Lafayette-FSAE/Carman-2021/CarMan KiCAD Schematics/Logic_2022/PiShield.jpg

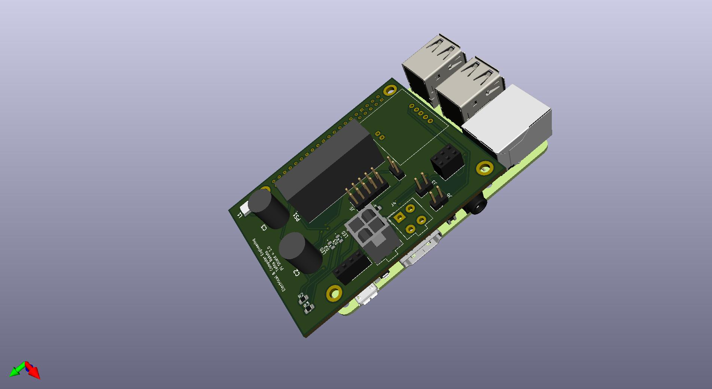
CarMan KiCAD Schematics/Logic_2022/PiShield.jpg
