Lafayette-FSAE/Carman-2021/CarMan KiCAD Schematics/Logic_2022/Logic_3D_Models/CUI_PYB20-Q24-S5-T.step

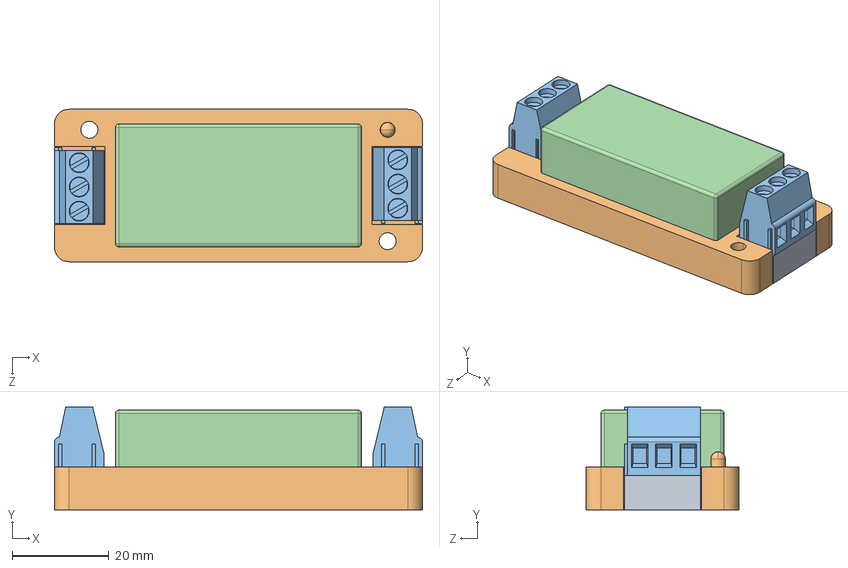
[picture p2: CAD file, 2021-02-16]
CarMan KiCAD Schematics/Logic_2022/Logic_3D_Models/CUI_PYB20-Q24-S5-T.step
76.0 x 21.2 x 31.5 mm
PYB1520-T cover
PYB1520-T case
DG128-5_DG128-5 (3) x 2
PYB20_PYB20-Q24-S5
