Lafayette-FSAE/Carman-2021/CarMan KiCAD Schematics/TSI/TSI_Rev.7/TSI_3D_Models/EHHD010A0B41-HZ--3DModel-STEP-56544.STEP

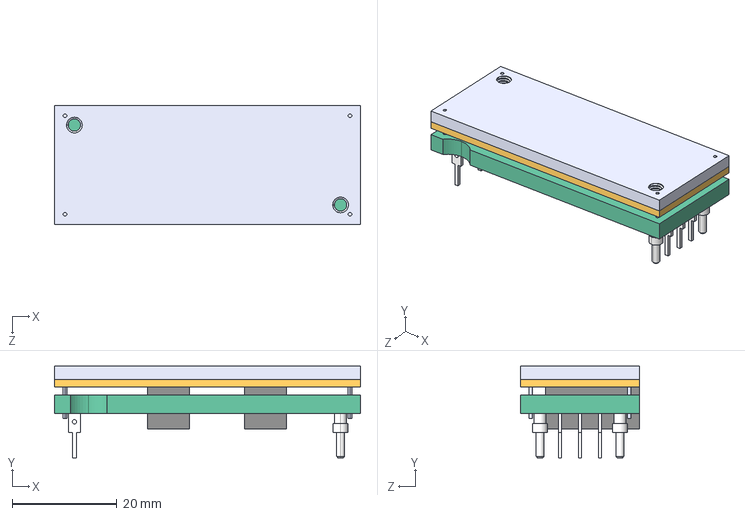
[picture p3: CAD file, 2021-02-16]
CarMan KiCAD Schematics/TSI/TSI_Rev.7/TSI_3D_Models/EHHD010A0B41-HZ--3DModel-STEP-56544.STEP
58.4 x 17.5 x 22.8 mm
