Lafayette-FSAE/Carman-2021/CarMan KiCAD Schematics/TSI/TSI_Rev.7/TSI_3D_Models/SFS2-DC24.step

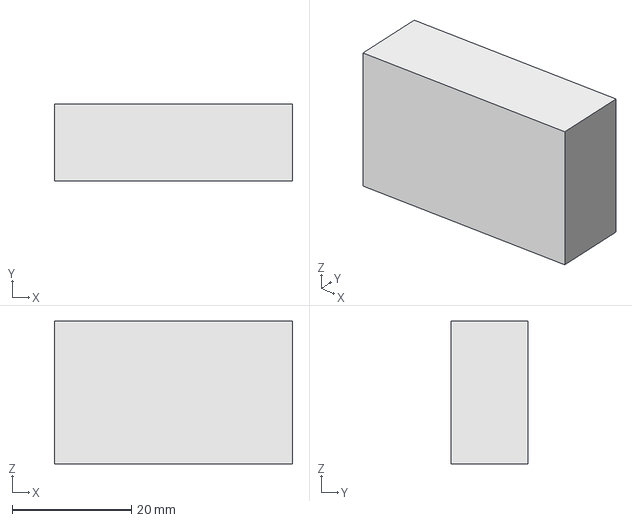
[picture p4: CAD file, 2021-02-16]
CarMan KiCAD Schematics/TSI/TSI_Rev.7/TSI_3D_Models/SFS2-DC24.step
40.0 x 13.0 x 24.0 mm
