Lafayette-FSAE/Carman-2021/CarMan KiCAD Schematics/Logic_2022/Logic_3D_Models/39281043.stp

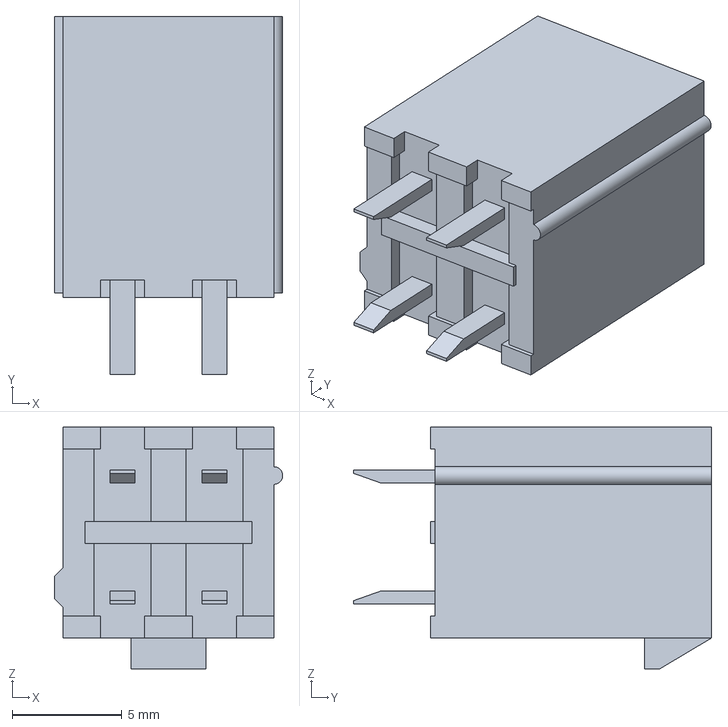
[picture p5: CAD file, 2021-02-16]
CarMan KiCAD Schematics/Logic_2022/Logic_3D_Models/39281043.stp
10.4 x 16.3 x 11.0 mm
