Lafayette-FSAE/Carman-2021/CarMan KiCAD Schematics/Logic_2022/Logic_3D_Models/39281023.stp

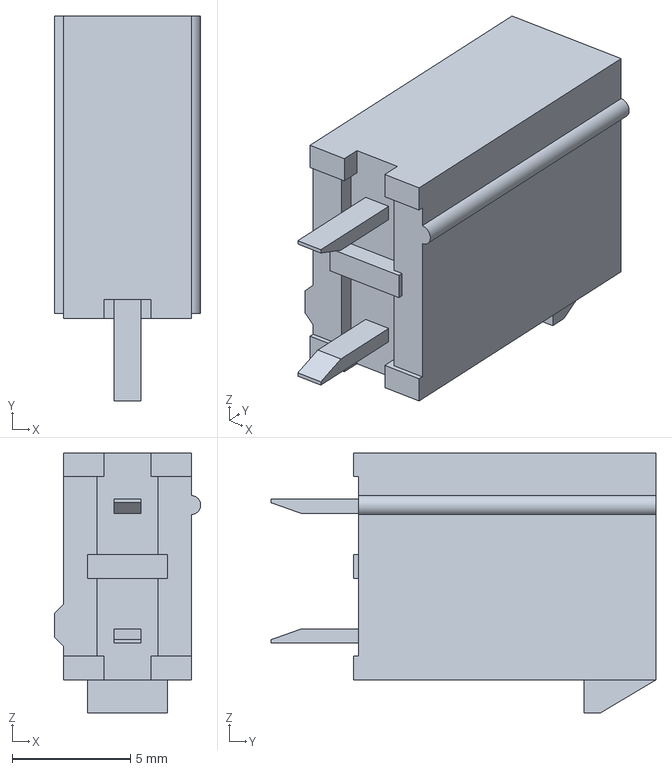
[picture p6: CAD file, 2021-02-16]
CarMan KiCAD Schematics/Logic_2022/Logic_3D_Models/39281023.stp
6.20 x 16.3 x 11.0 mm
