Lafayette-FSAE/Carman-2021/CarMan KiCAD Schematics/Logic_2022/Logic_3D_Models/39281063.stp

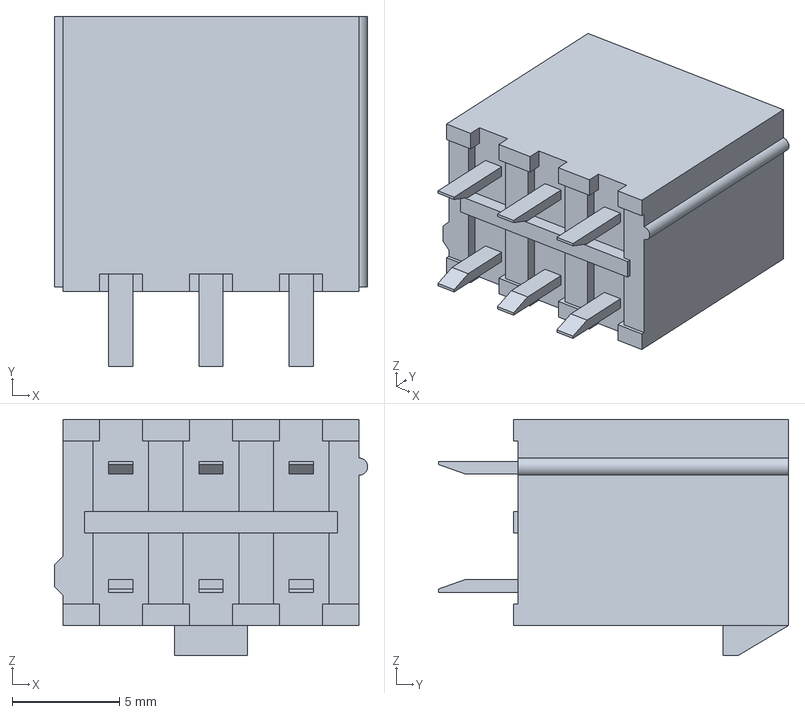
[picture p7: CAD file, 2021-02-16]
CarMan KiCAD Schematics/Logic_2022/Logic_3D_Models/39281063.stp
14.6 x 16.3 x 11.0 mm
