Lafayette-FSAE/Carman-2021/CarMan KiCAD Schematics/Logic_2022/PiShield.pdf

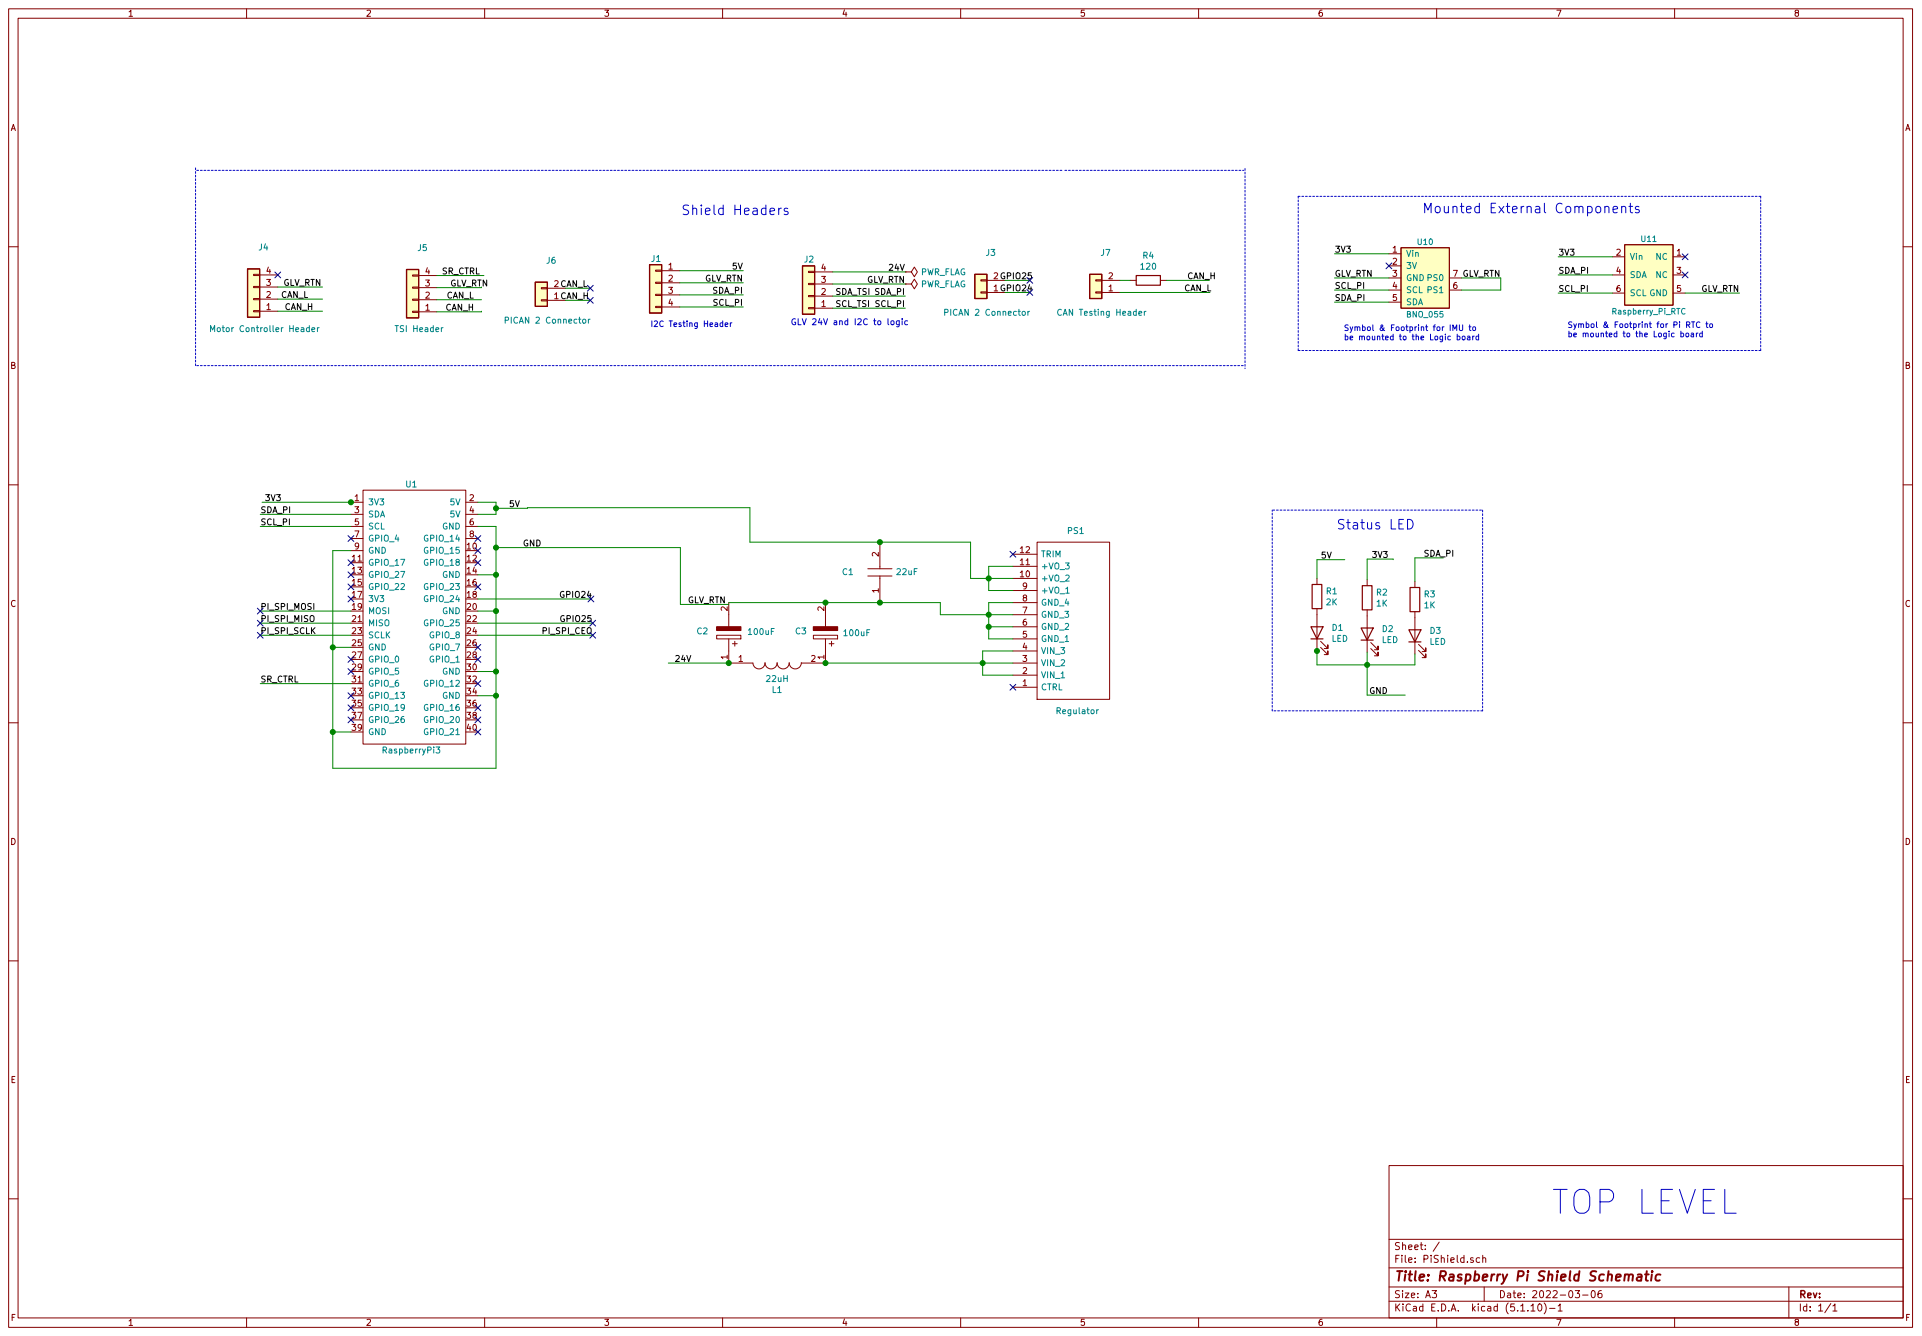
[picture p9: page 1]

be mounted to the Logic board Shield Headers

Symbol & Footprint for IMU to

Symbol & Footprint for Pi RTC to
be mounted to the Logic board

File: PiShield.sch Sheet: /
Id: 1/1 Title: Raspberry Pi Shield Schematic
