Lafayette-FSAE/Carman-2021/CarMan KiCAD Schematics/EPAL/EPAL.pdf

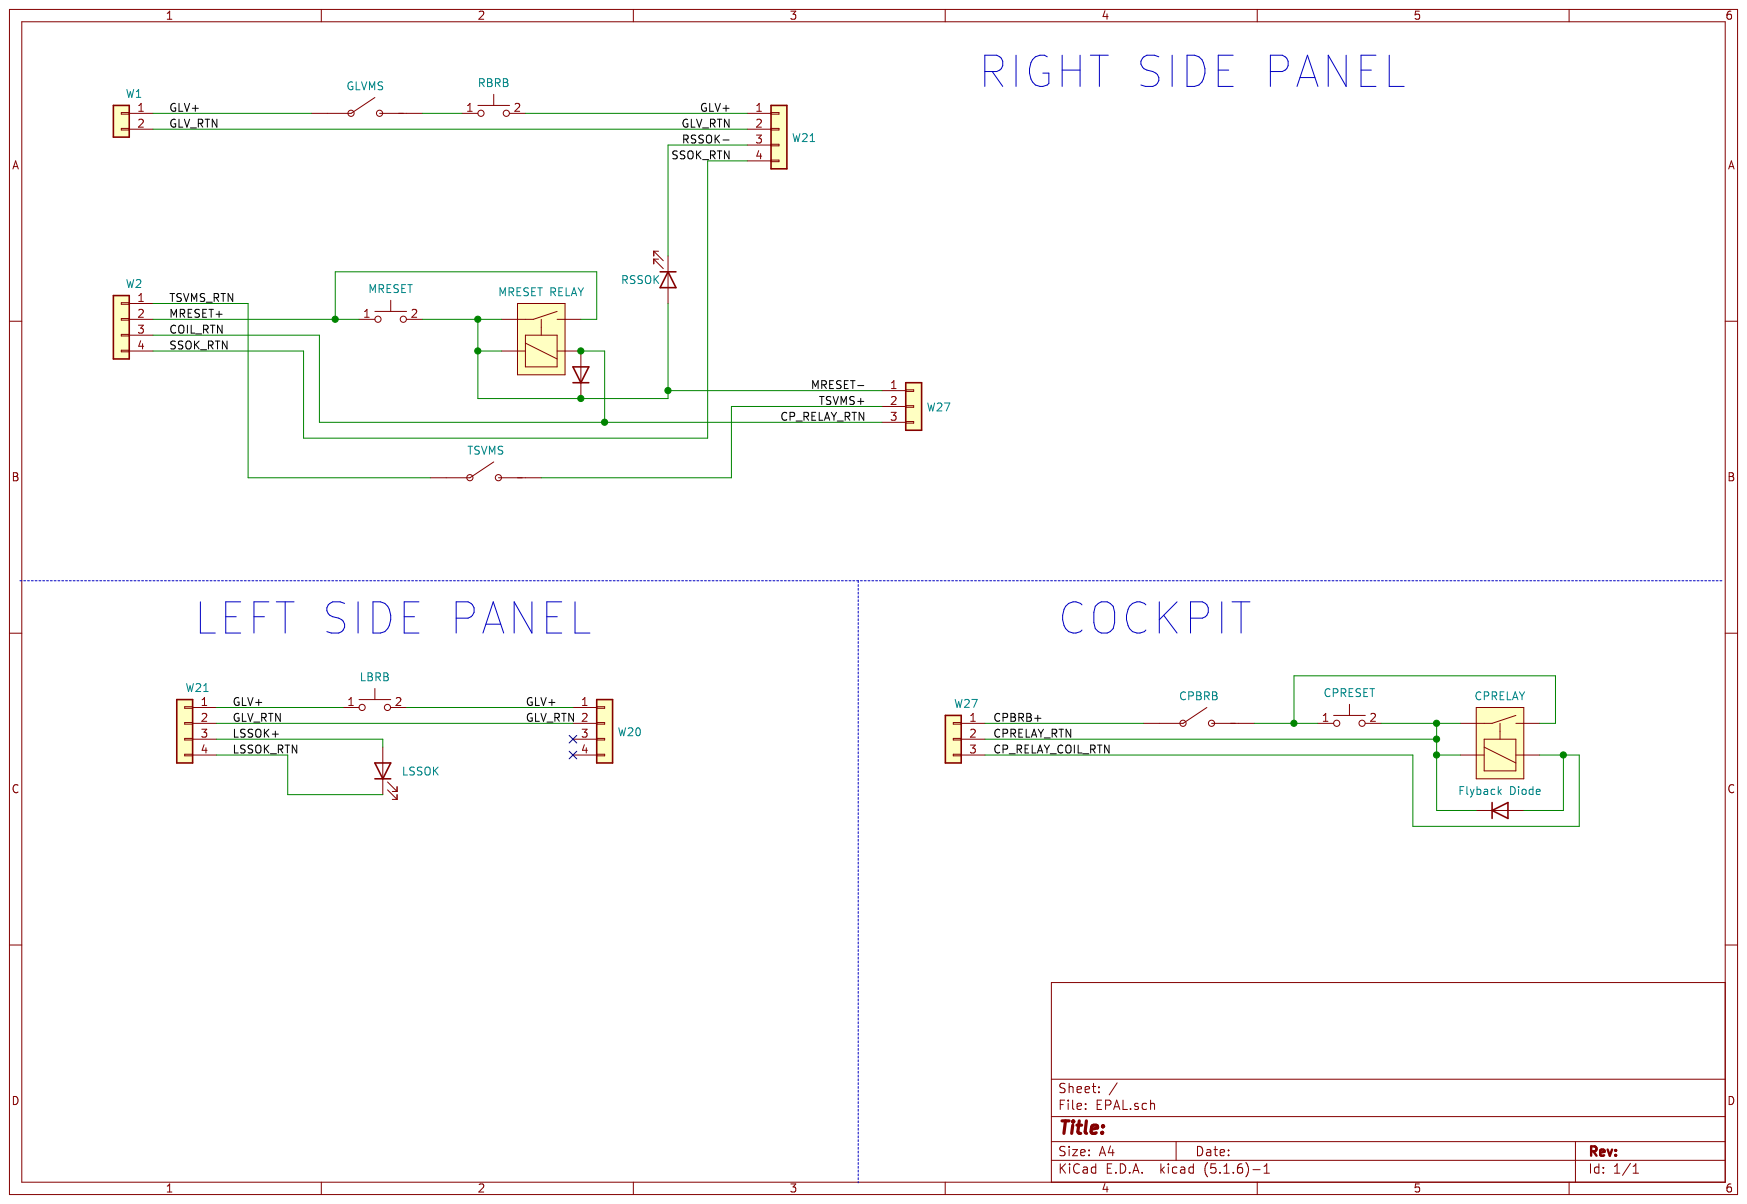
[picture p10: page 1]
