Lafayette-FSAE/Carman-2021/CarMan KiCAD Schematics/Logic_2022/PiShield.kicad_pcb

## KiCad design CarMan KiCAD Schematics/Logic_2022/PiShield.kicad_pcb (2022-04-07)

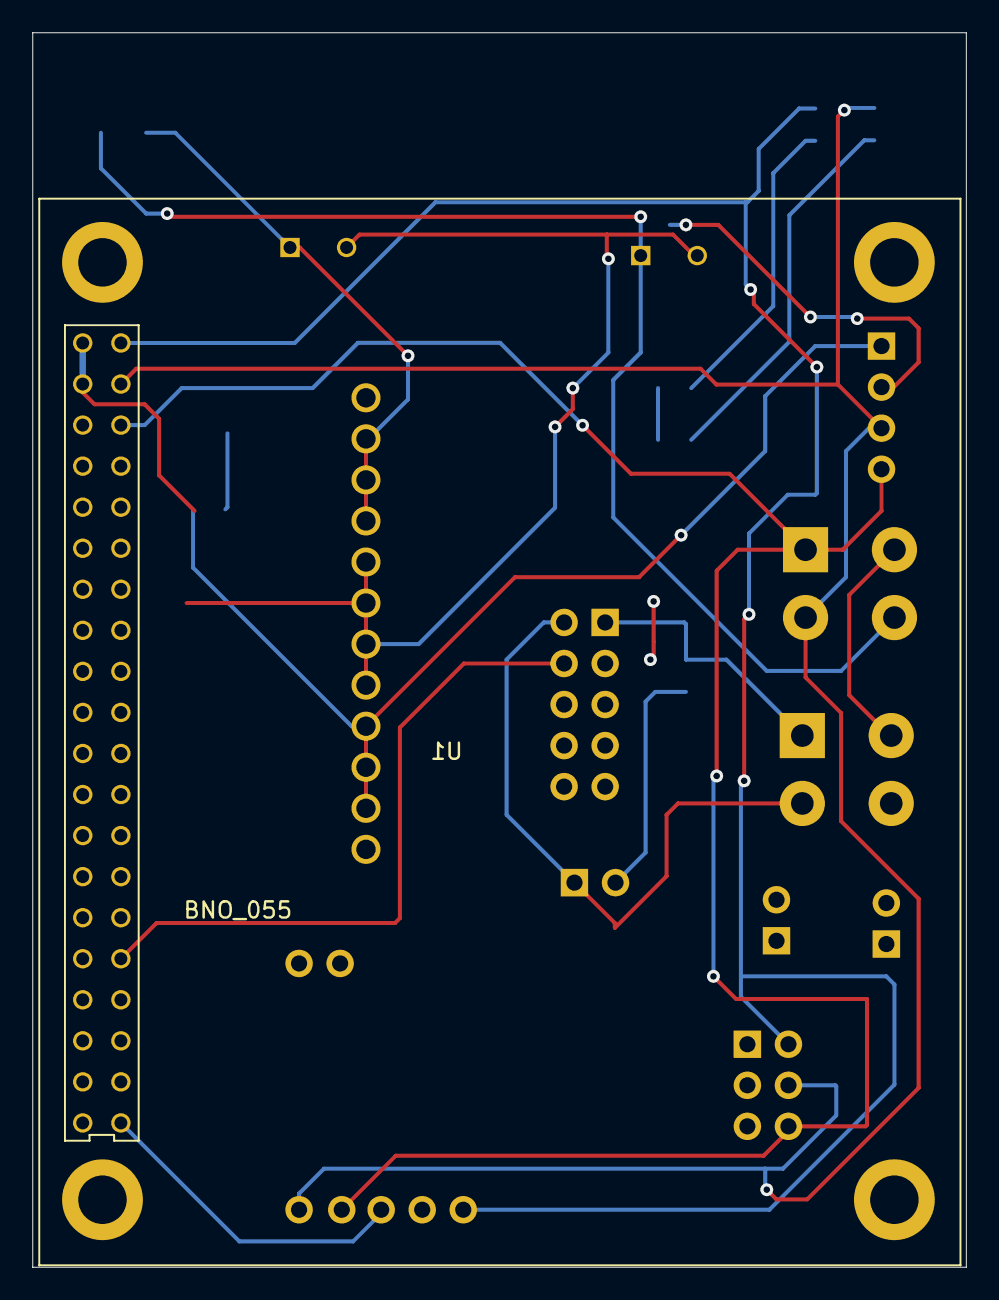
[picture p16: board PiShield.kicad_pcb from above]

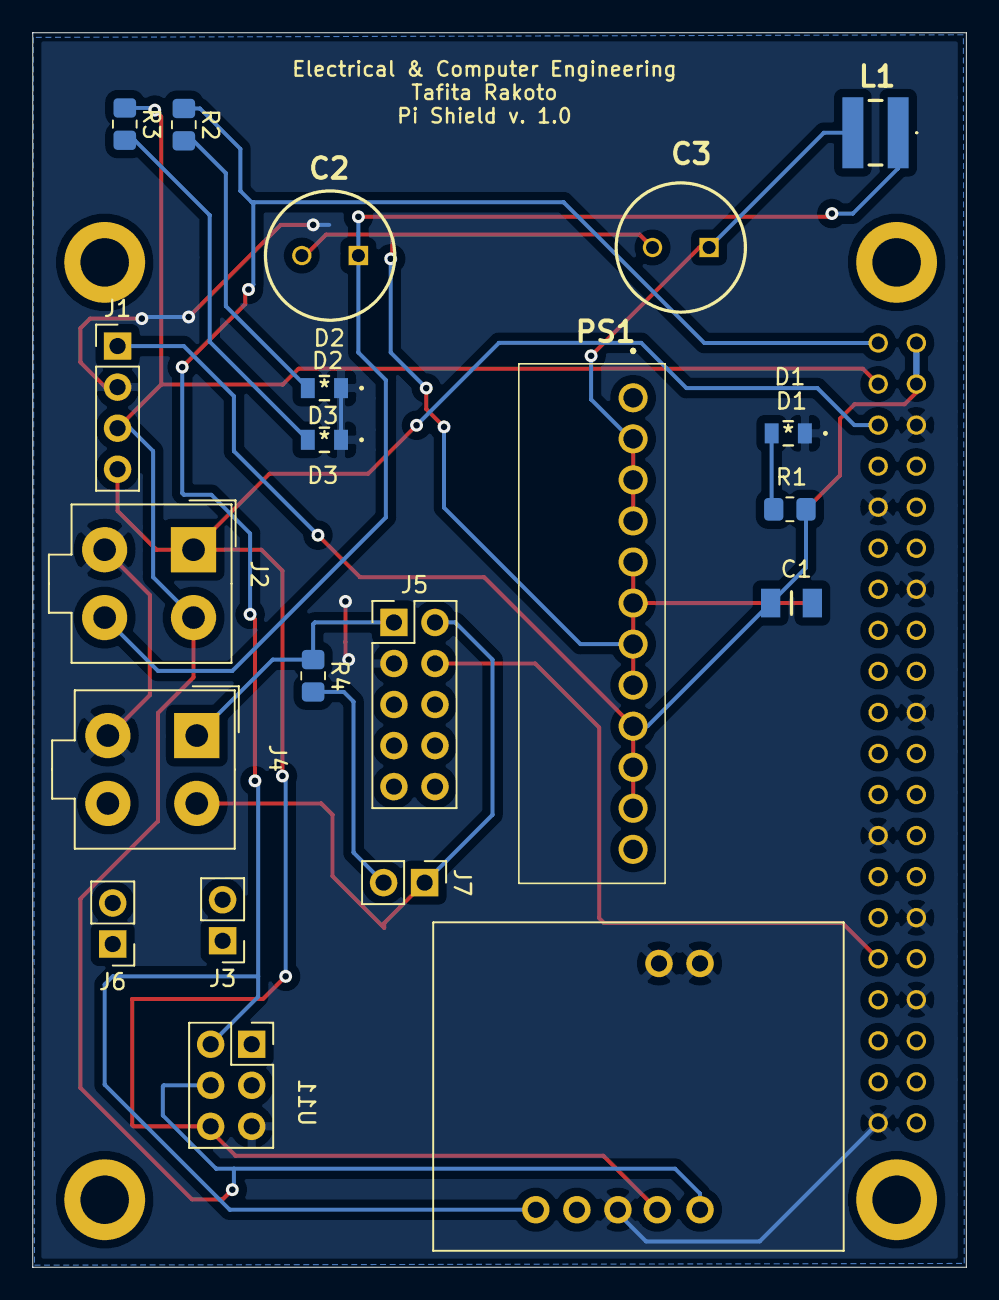
[picture p17: board PiShield.kicad_pcb from below]

Board: 2 copper layers, 57.8 x 76.4 mm, 22 parts (21 on the bottom side), 15 nets.

Parts:
C1: 22uF; CAPC3216X180N
C2, C3: 100uF; CAPPRD350W60D800H1250
D1: D1; VAOL-S8GT4
D2: D2; VAOL-S8GT4
D3: D3; VAOL-S8GT4
J1: I2C Testing Header; PinHeader_1x04_P2.54mm_Vertical
J2: J2; Molex_MiniFit-JR-5556-04A_2x02x4.20mm_Straight
J3: J3; PinHeader_1x02_P2.54mm_Vertical
J4: J4; Molex_MiniFit-JR-5556-04A_2x02x4.20mm_Straight
J5: J5; PinHeader_2x05_P2.54mm_Vertical
J6: J6; PinHeader_1x02_P2.54mm_Vertical
J7: J7; PinHeader_1x02_P2.54mm_Vertical
L1: 22uH; VLS4012HBX220MN
PS1: PS1; P783Q24S5S
R1: 2K; R_0805_2012Metric_Pad1.20x1.40mm_HandSolder
R2, R3: 1K; R_0805_2012Metric_Pad1.20x1.40mm_HandSolder
R4: 120; R_0805_2012Metric_Pad1.20x1.40mm_HandSolder
U1: RaspberryPi3; Raspberry_Pi_3_B
U10: BNO_055
U11: Raspberry_Pi_RTC

Connections:
/3V3: R2.1, U1.1, U10.1, U11.2
/5V: C1.2, J1.1, PS1.9, PS1.10, PS1.11, R1.1, U1.2, U1.4
/24V: C2.1, J2.4, L1.1
/CAN_H: J4.1, J5.1, R4.1
/CAN_L: J4.2, J5.2, J7.1
/GLV_RTN: D1.1, D2.1, D3.1, J1.2, J2.3, J4.3, J5.3, U1.6, U1.9, U1.14, U1.20, U1.25, U1.30, U1.34, U1.39, U10.3, U10.6, U10.7, U11.5
/SCL_PI: J1.4, J2.1, U1.5, U10.4, U11.6
/SDA_PI: J1.3, J2.2, R3.1, U1.3, U10.5, U11.4
/SR_CTRL: J5.4, U1.31
unnamed: C1.1, C2.2, C3.2, PS1.5, PS1.6, PS1.7, PS1.8
unnamed: C3.1, L1.2, PS1.2, PS1.3, PS1.4
unnamed: D1.2, R1.2
unnamed: D2.2, R2.2
unnamed: D3.2, R3.2
unnamed: J7.2, R4.2
