Lafayette-FSAE/Carman-2021/CarMan KiCAD Schematics/TSI/TSI_Rev.7/TSI_Rev.7.kicad_pcb

## KiCad design CarMan KiCAD Schematics/TSI/TSI_Rev.7/TSI_Rev.7.kicad_pcb (continued)

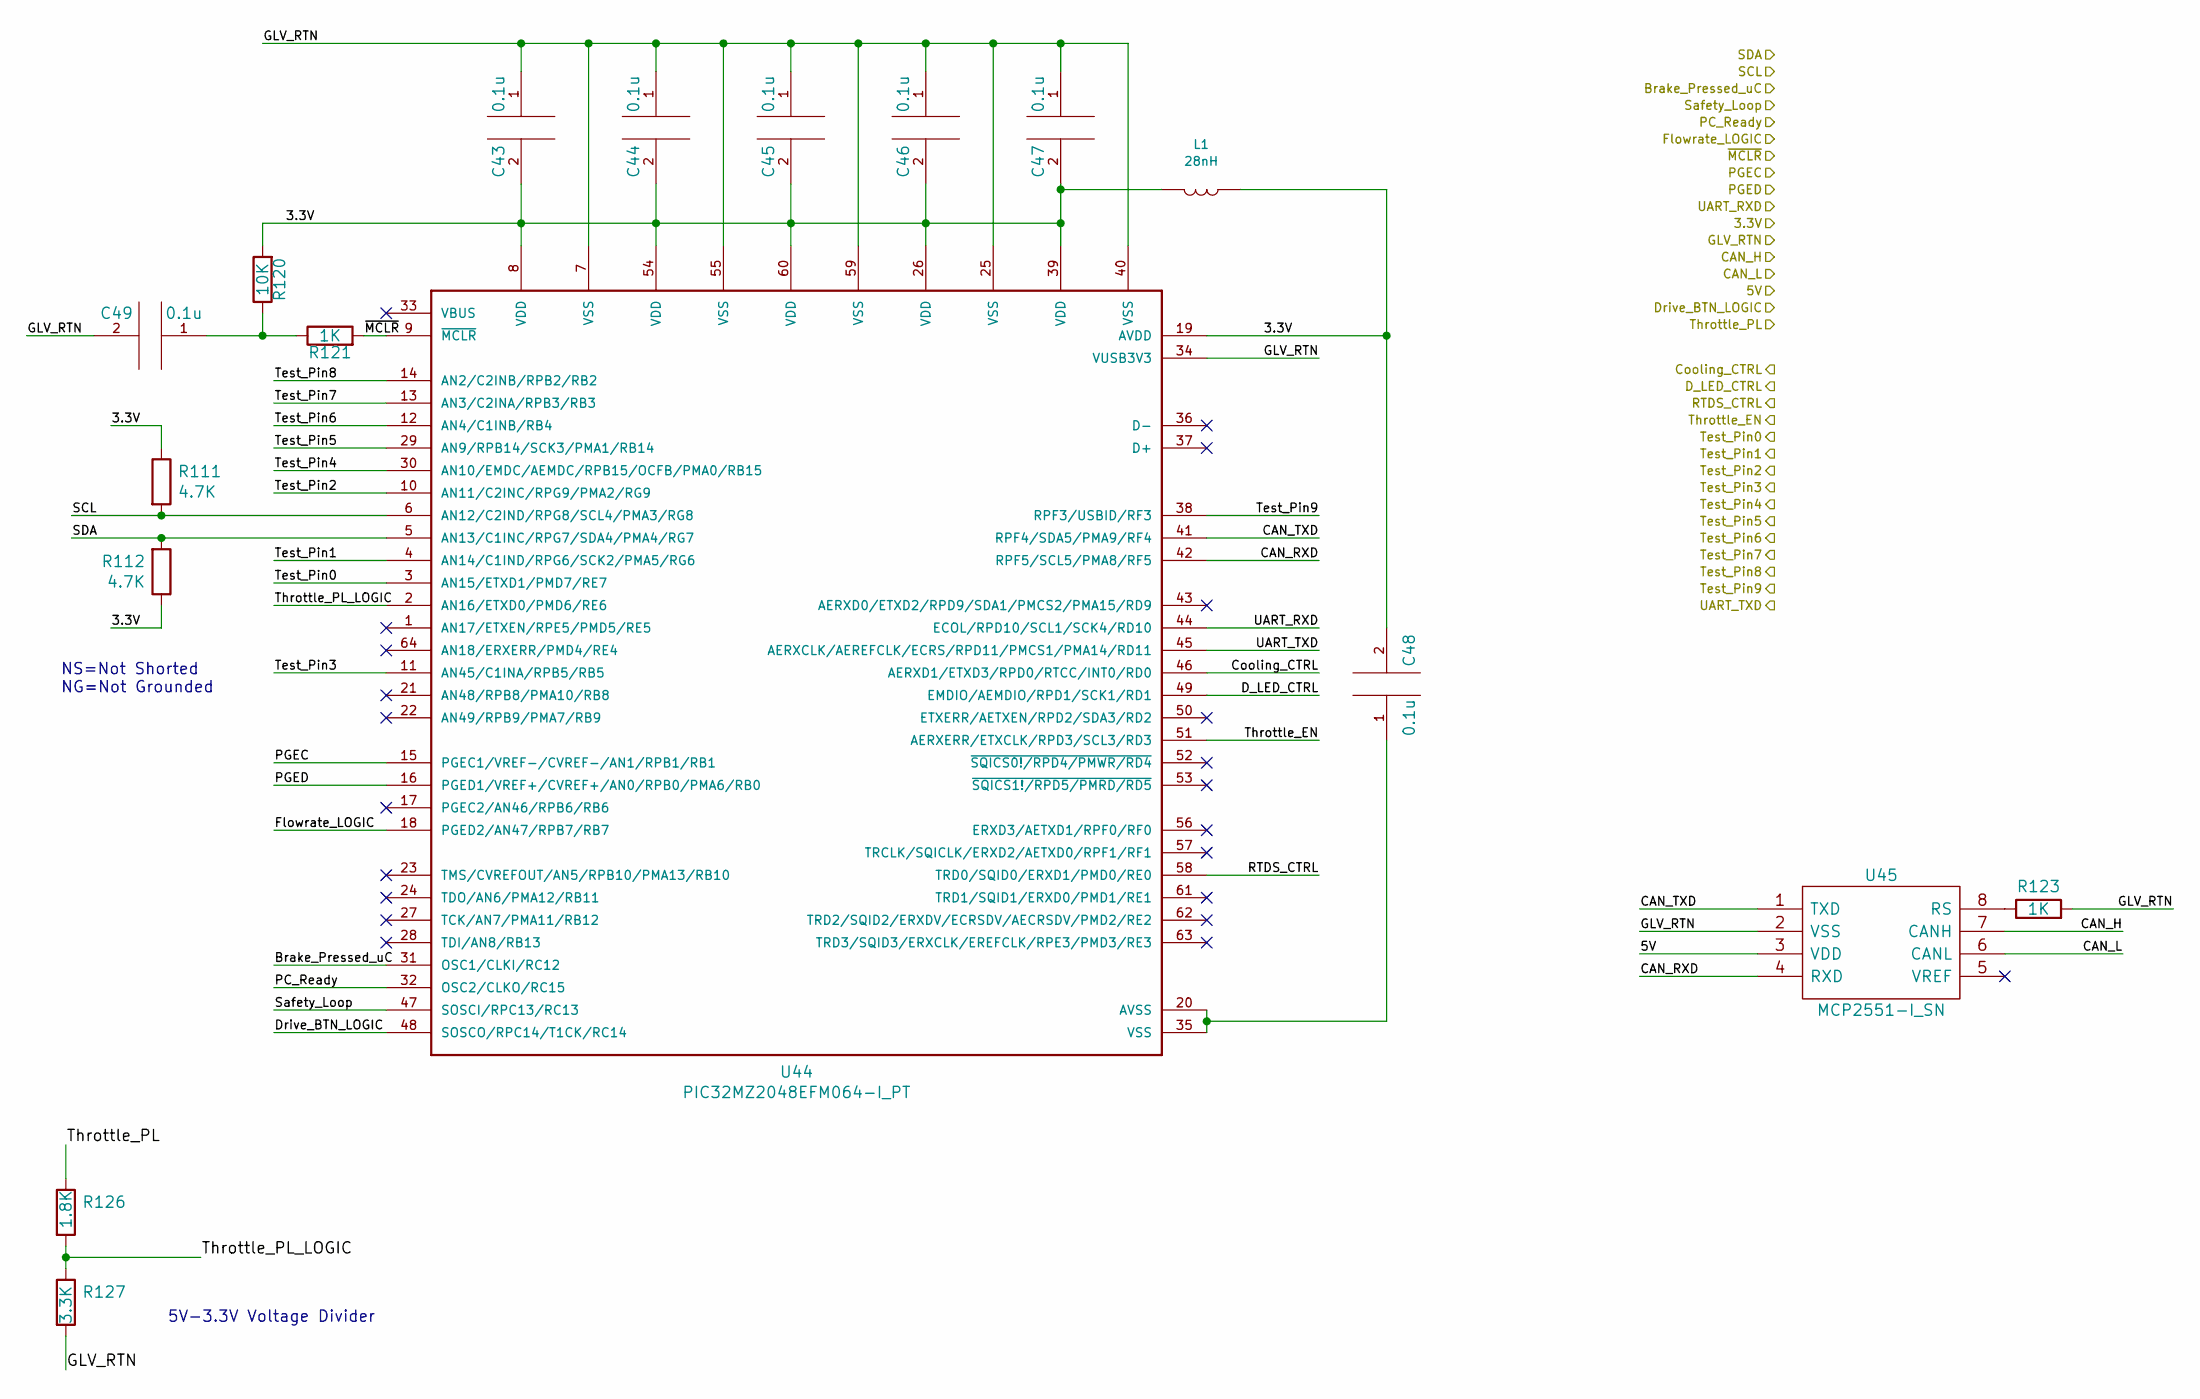
[picture p27: schematic PIC32.sch]

Parts:
C43, C44, C45, C46, C47, C48, C49: 0.1u; C_0805_2012Metric_Pad1.18x1.45mm_HandSolder
L1: 28nH; L_0805_2012Metric_Pad1.15x1.40mm_HandSolder
R111, R112: 4.7K; R_0805_2012Metric_Pad1.20x1.40mm_HandSolder
R120: 10K; R_0805_2012Metric_Pad1.20x1.40mm_HandSolder
R121, R123: 1K; R_0805_2012Metric_Pad1.20x1.40mm_HandSolder
R126: 1.8K; R_0805_2012Metric_Pad1.20x1.40mm_HandSolder
R127: 3.3K; R_0805_2012Metric_Pad1.20x1.40mm_HandSolder
U44: PIC32MZ2048EFM064-I_PT; QFP50P1200X1200X120-64N
U45: MCP2551-I_SN; SOIC127P600X175-8N; Manufacturer_Part_Number MCP2551-I/SN; Mouser Part Number 579-MCP2551-I/SN

Connections:
/3.3V: C43.2, C44.2, C45.2, C46.2, C47.2, C48.2, L1.1, L1.2, R111.1, R112.1, R120.2, U44.8 (VDD), U44.19 (AVDD), U44.26 (VDD), U44.39 (VDD), U44.54 (VDD), U44.60 (VDD); also elsewhere on the board
/5V: U45.3 (VDD); also elsewhere on the board
/AIRS-: C43.1, C44.1, C45.1, C46.1, C47.1, C49.2, R123.2, R127.2, U44.7 (VSS), U44.25 (VSS), U44.34 (VUSB3V3), U44.40 (VSS), U44.55 (VSS), U44.59 (VSS), U45.2 (VSS); also elsewhere on the board
/BP_CAN+: U45.7 (CANH); also elsewhere on the board
/BP_CAN-: U45.6 (CANL); also elsewhere on the board
/Brake_Pressed_uC: U44.31 (OSC1/CLKI/RC12); also elsewhere on the board
/Cooling_CTRL: U44.46 (AERXD1/ETXD3/RPD0/RTCC/INT0/RD0); also elsewhere on the board
/D_LED_CTRL: U44.49 (EMDIO/AEMDIO/RPD1/SCK1/RD1); also elsewhere on the board
/Drive_BTN_LOGIC: U44.48 (SOSCO/RPC14/T1CK/RC14); also elsewhere on the board
/Flowrate_LOGIC: U44.18 (PGED2/AN47/RPB7/RB7); also elsewhere on the board
/PC_Ready: U44.32 (OSC2/CLKO/RC15); also elsewhere on the board
/PGEC: U44.15 (PGEC1/VREF-/CVREF-/AN1/RPB1/RB1); also elsewhere on the board
/PGED: U44.16 (PGED1/VREF+/CVREF+/AN0/RPB0/PMA6/RB0); also elsewhere on the board
/PIC32/CAN_RXD: U44.42 (RPF5/SCL5/PMA8/RF5), U45.4 (RXD)
/PIC32/CAN_TXD: U44.41 (RPF4/SDA5/PMA9/RF4), U45.1 (TXD)
/PIC32/Throttle_PL_LOGIC: R126.2, R127.1, U44.2 (AN16/ETXD0/PMD6/RE6)
/RTDS_CTRL: U44.58 (TRD0/SQID0/ERXD1/PMD0/RE0); also elsewhere on the board
/SCL: R111.2, U44.6 (AN12/C2IND/RPG8/SCL4/PMA3/RG8); also elsewhere on the board
/SDA: R112.2, U44.5 (AN13/C1INC/RPG7/SDA4/PMA4/RG7); also elsewhere on the board
/Safety_Loop: U44.47 (SOSCI/RPC13/RC13); also elsewhere on the board
/Test_Pin0: U44.3 (AN15/ETXD1/PMD7/RE7); also elsewhere on the board
/Test_Pin1: U44.4 (AN14/C1IND/RPG6/SCK2/PMA5/RG6); also elsewhere on the board
/Test_Pin2: U44.10 (AN11/C2INC/RPG9/PMA2/RG9); also elsewhere on the board
/Test_Pin3: U44.11 (AN45/C1INA/RPB5/RB5); also elsewhere on the board
/Test_Pin4: U44.30 (AN10/EMDC/AEMDC/RPB15/OCFB/PMA0/RB15); also elsewhere on the board
/Test_Pin5: U44.29 (AN9/RPB14/SCK3/PMA1/RB14); also elsewhere on the board
/Test_Pin6: U44.12 (AN4/C1INB/RB4); also elsewhere on the board
/Test_Pin7: U44.13 (AN3/C2INA/RPB3/RB3); also elsewhere on the board
/Test_Pin8: U44.14 (AN2/C2INB/RPB2/RB2); also elsewhere on the board
/Test_Pin9: U44.38 (RPF3/USBID/RF3); also elsewhere on the board
/Throttle_EN: U44.51 (AERXERR/ETXCLK/RPD3/SCL3/RD3); also elsewhere on the board
/Throttle_PL: R126.1; also elsewhere on the board
/UART_RXD: U44.44 (ECOL/RPD10/SCL1/SCK4/RD10); also elsewhere on the board
/UART_TXD: U44.45 (AERXCLK/AEREFCLK/ECRS/RPD11/PMCS1/PMA14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); also elsewhere on the board
/~MCLR: R121.2, U44.9 (~MCLR~); also elsewhere on the board
unnamed: C48.1, U44.20 (AVSS), U44.35 (VSS)
unnamed: C49.1, R120.1, R121.1
unnamed: R123.1, U45.8 (RS)

Notes on the sheet:
NS=Not Shorted NG=Not Grounded
5V-3.3V Voltage Divider

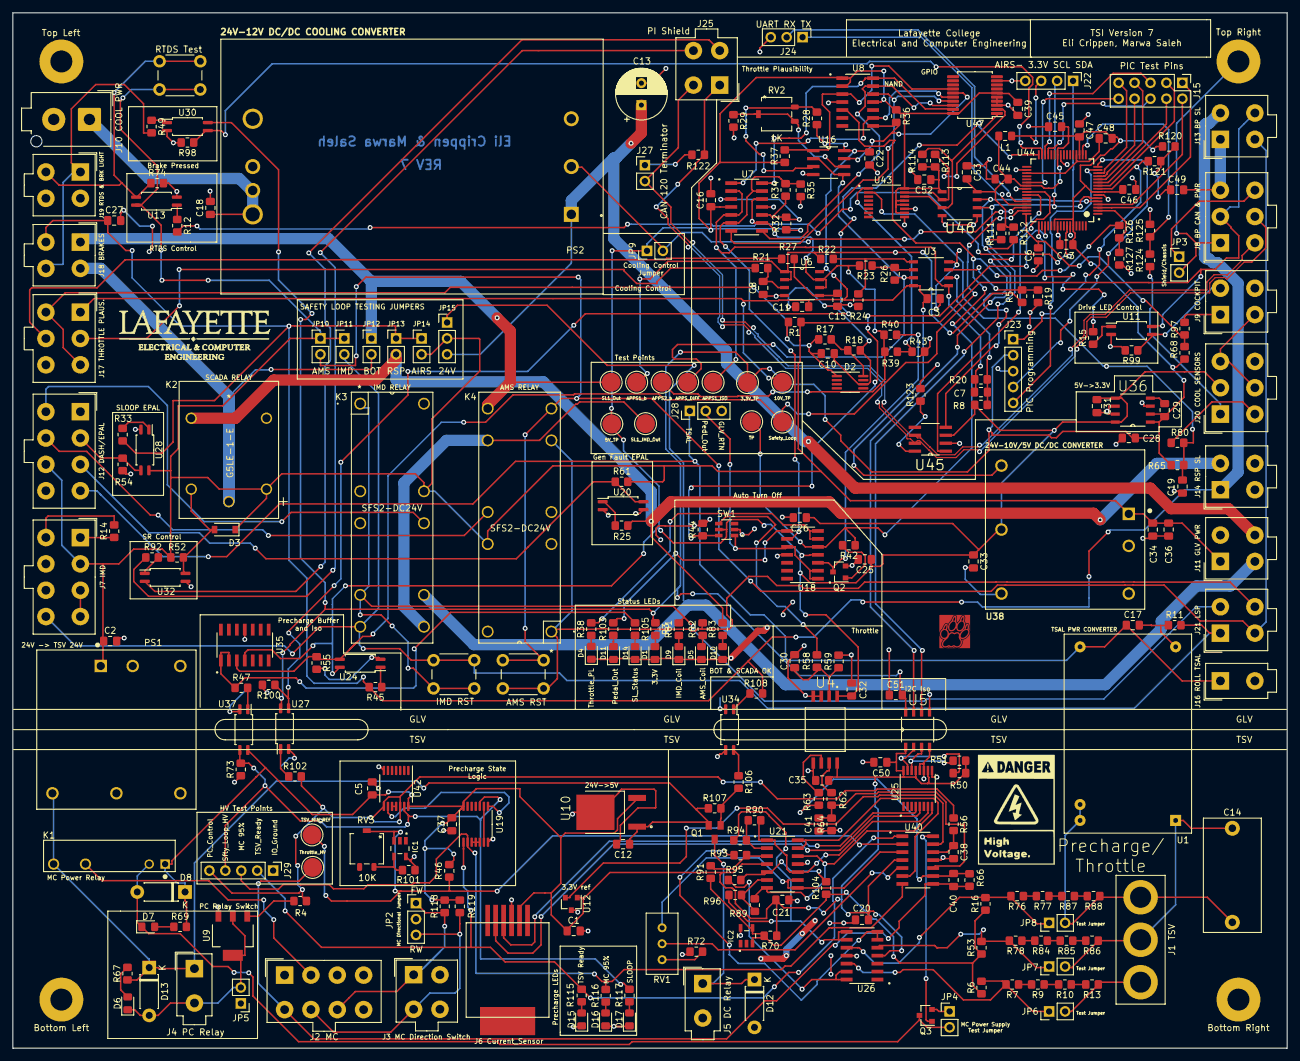
[picture p28: board TSI_Rev.7.kicad_pcb from above]

Board: 2 copper layers, 203.2 x 165.1 mm, 295 parts (0 on the bottom side), 192 nets.

Other parts of the board:
VAL: REF; lafLogo
