Lafayette-FSAE/Carman-2021/CarMan KiCAD Schematics/GLV_BOBV6/GLV_BOBV6.kicad_pcb

## KiCad design CarMan KiCAD Schematics/GLV_BOBV6/GLV_BOBV6.kicad_pcb (2021-04-27)

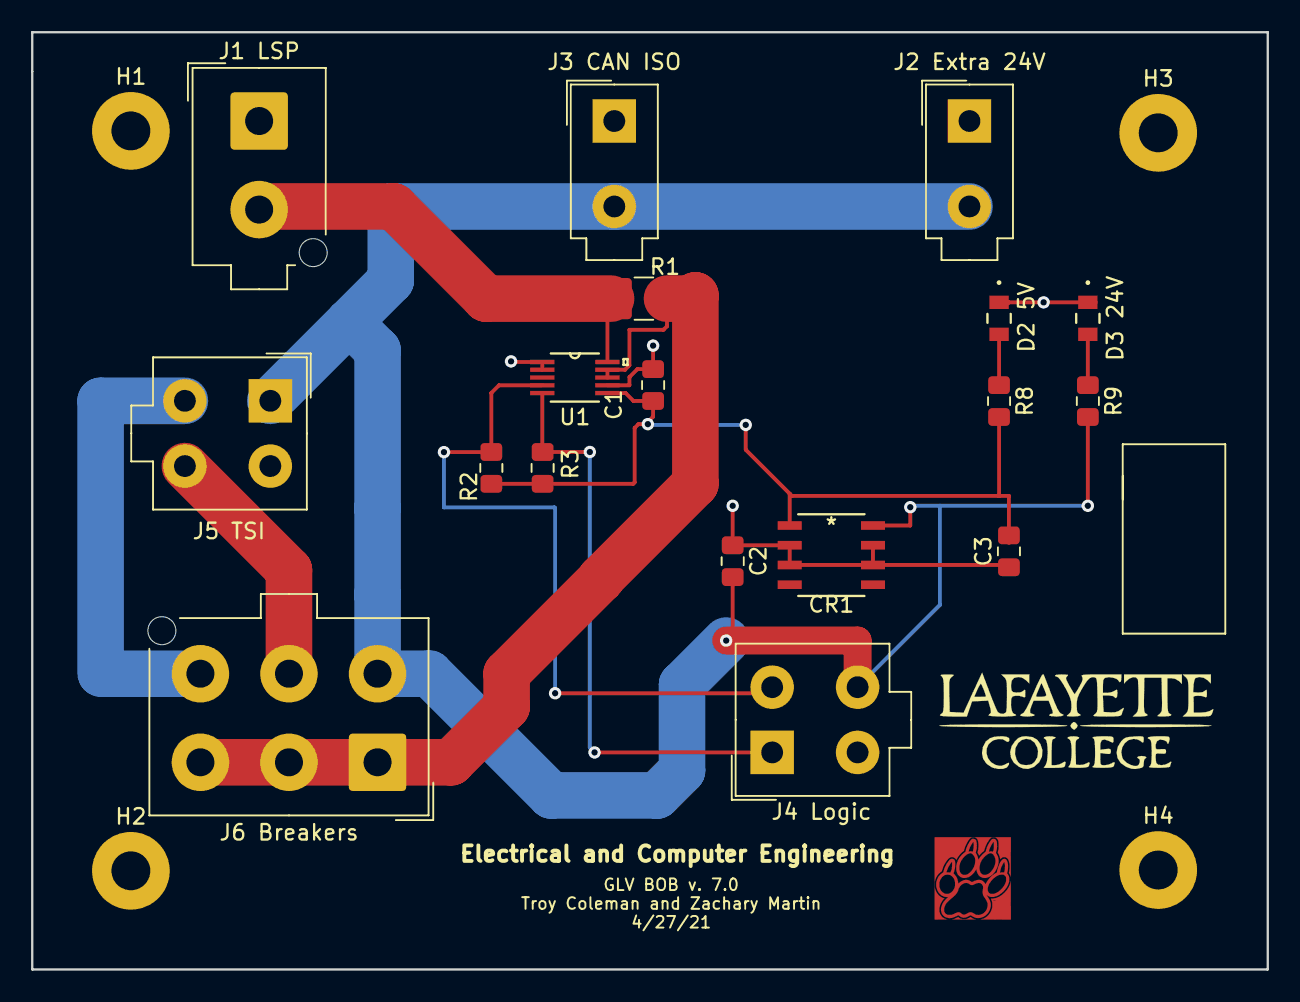
[picture p29: board GLV_BOBV6.kicad_pcb from above]

Board: 2 copper layers, 79.5 x 60.3 mm, 23 parts (0 on the bottom side), 11 nets.

Parts:
C1, C3: 0.1uF; C_0805_2012Metric_Pad1.15x1.40mm_HandSolder
C2: 0.33uF; C_0805_2012Metric_Pad1.15x1.40mm_HandSolder
CR1: L78L05ACD13TR
D2 5V, D3 24V: LED; VAOL-S8GT4
H1, H2, H3, H4: MountingHole; MountingHole_2.5mm_Pad
J1 LSP: Conn_01x02; Molex_Mega-Fit_76829-0102_2x01_P5.70mm_Vertical
J2 Extra 24V, J3 CAN ISO: Conn_01x02; Molex_MiniFit-JR-5556-02A_2x01x4.20mm_Straight
J4 Logic, J5 TSI: Conn_02x02_Odd_Even; Molex_MiniFit-JR-5556-04A_2x02x4.20mm_Straight
J6 Breakers: J6; Molex_Mega-Fit_76829-0106_2x03_P5.70mm_Vertical
R1: 0.001; R_1210_3225Metric_Pad1.42x2.65mm_HandSolder
R2, R3, R8, R9: 10K; R_0805_2012Metric_Pad1.15x1.40mm_HandSolder
U1: INA226AIDGSR
VAL: REF; lafLogo

Connections:
/5V_NON_ISO: C1.1, C3.2, CR1.1, R2.1, R3.1, R8.2, U1.6
/24V: C2.2, CR1.8, J2 Extra 24V.2, J3 CAN ISO.2, J4 Logic.4, J5 TSI.1, J6 Breakers.4, R9.2
/24V_NOT_BREAKERED: J6 Breakers.1, J6 Breakers.2, J6 Breakers.3, R1.1, U1.8, U1.9
/BATT+: J1 LSP.2, R1.2, U1.10
/BREAKER_OUT_COOL: J5 TSI.4, J6 Breakers.5
/BREAKER_OUT_SL: J5 TSI.3, J6 Breakers.6
/GLV_RTN: C1.2, C2.1, C3.1, CR1.2, CR1.3, CR1.6, CR1.7, D2 5V.1, D3 24V.1, J1 LSP.1, J2 Extra 24V.1, J3 CAN ISO.1, J4 Logic.3, J5 TSI.2, U1.1, U1.2, U1.7
/SCL_NOT_ISO: J4 Logic.1, R3.2, U1.5
/SDA_NOT_ISO: J4 Logic.2, R2.2, U1.4
unnamed: D2 5V.2, R8.1
unnamed: D3 24V.2, R9.1
