Lafayette-FSAE/Carman-2021/(commit log)

2020-10-20 Added Folders for each board
2020-10-25 8 Pin Addition
2020-10-25 New Upload
    [TSI_Rev.5.kicad_pcb, TSI_Rev.5.sch]
2020-10-25 Top-Level TSI
    [TSI_Rev.5.sch]
2020-10-25 Updated Libraries and created logic board
    [Logic.kicad_pcb, Logic.sch, PIC32.sch, SCADA.sch]
2020-10-25 Added GLV Schematic
    [GLV_BOBV6.kicad_pcb, GLV_BOBV6.sch]
2020-10-25 TSI KiCAD- TP
    [TSI_Rev.5.sch]
2020-10-26 Lib Update, TSi Update
    [TSI_Rev.5.sch]
2020-10-26 GLV with VA Sensor and I2C ISO
    [sensorGLV.sch]
2020-10-26 TSI-TP Update
    [TSI_Rev.5.sch, TSI_Throttle_Plausibility.sch]
2020-10-27 TSI update
    [TSI_Rev.5.sch, TSI_Throttle_Plausibility.sch]
2020-10-27 GLV Schematic/Library Update
    [GLV_BOBV6.sch]
2020-10-27 GLV Schematic Fix - Logic Power
    [GLV_BOBV6.sch, sensorGLV.sch]
2020-10-27 Finished Logic Board schematic and removed old schematics
    [Logic.sch, PIC32.sch, PiHat.sch, SCADA.sch]
2020-10-27 GLV Comment
    [GLV_BOBV6.sch]
2020-10-27 u dumb
    [TSI_Throttle_Plausibility.sch]
2020-10-27 Update, error fix
    [PCDC_Circuit.sch, TSI_Rev.5.sch, TSI_Throttle_Plausibility.sch]
2020-10-27 Refactored repo
    [Logic.kicad_pcb, Logic.sch, PiHat.sch]
2020-10-27 GLV Tentatively Finished
    [GLV_BOBV6.sch, sensorGLV.sch]
2020-10-27 GLV Tentatively Finished with part labels
    [GLV_BOBV6.sch]
2020-10-27 Sensors & Throttle Iso
    [PCDC_Circuit.sch, Sensors-Throttle.sch, TSI_Rev.5.sch, TSI_Throttle_Plausibility.sch]
2020-10-27 Sensors &Throttle ISO 2
2020-10-27 Finished temp/current sensor and TV ISO
    [Sensors-Throttle.sch, TSI_Rev.5.sch]
2020-10-27 Update Lib
    [CAN_GLV_POWER.sch, PCDC_Circuit.sch, Sensors-Throttle.sch, StatusLights_Cockpit.sch, TSI_Rev.5.sch, TSI_Throttle_Plausibility.sch]
2020-10-28 GLV with Cooling Connector
    [GLV_BOBV6.sch]
2020-10-28 Update lib, TSAL & CAN/GLV
    [CAN_GLV_POWER.sch, PCDC_Circuit.sch, Sensors-Throttle.sch, StatusLights_Cockpit.sch, TSI_Rev.5.sch, TSI_Throttle_Plausibility.sch]
2020-10-28 TSI Fixes - Hi Neal
    [CAN_GLV_POWER.sch, PCDC_Circuit.sch, Sensors-Throttle.sch, StatusLights_Cockpit.sch, TSI_Rev.5.sch, TSI_Throttle_Plausibility.sch]
2020-10-28 Updated Logic to run off of 5V not 24V
    [Logic.sch, TSI-Cooling.sch, TSI_Rev.5.kicad_pcb]
2020-10-29 Fixed More TSI connections/renamed things
    [CAN_GLV_POWER.sch, PCDC_Circuit.sch, Sensors-Throttle.sch, StatusLights_Cockpit.sch, TSI_Rev.5.sch, TSI_Throttle_Plausibility.sch]
2020-10-29 TSI - Added 24V- 5v isolated converter, Scada relay, and fixed connections
    [CAN_GLV_POWER.sch, Logic_Power_And_CAN_Isolators.sch, PCDC_Circuit.sch, Sensors-Throttle.sch, StatusLights_Cockpit.sch, TSI_Rev.5.sch, TSI_Throttle_Plausibility.sch]
2020-10-29 Res/Cap Value Updates & Organizational
    [CAN_GLV_POWER.sch, PCDC_Circuit.sch, Sensors-Throttle.sch, StatusLights_Cockpit.sch, TSI_Rev.5.sch, TSI_Throttle_Plausibility.sch]
2020-10-30 Added Cooling isolator and fault logic sheet
    [CAN_GLV_POWER.sch, Fault_Logic_And_Timing_Circuit.sch, PCDC_Circuit.sch, Sensors-Throttle.sch, StatusLights_Cockpit.sch, TSI_Rev.5.sch, TSI_Throttle_Plausibility.sch]
2020-10-30 Added isolation to CANBUS
    [Logic.sch, PiHat.sch]
2020-10-30 Actually isolated things this time
    [Logic.sch]
2020-10-30 Pls help
    [CAN_GLV_POWER.sch, Logic_Power_And_CAN_Isolators.sch, PCDC_Circuit.sch, Sensors-Throttle.sch, StatusLights_Cockpit.sch, TSI_Rev.5.sch, TSI_Throttle_Plausibility.sch]
2020-10-31 Added convertor for IMD_Status, fixed IMD/AMS led logic and Reset RC timing.
    [Fault_Logic_And_Timing_Circuit.sch]
2020-11-01 Segmented TSI connectors to be HV and LV, Removed redundant IMD LED logic.
    [CAN_GLV_POWER.sch, StatusLights_Cockpit.sch, TSI_Rev.5.sch]
2020-11-01 Updated GLV with breaker connectors and connections, changed I2C PU resistors, added remaining pwr flags.
    [GLV_BOBV6.sch, sensorGLV.sch]
2020-11-02 Fixed Logic library issue, added I2C translator to Logic, matched I2C names for TSI-Logic
    [Logic.sch, PiHat.sch, TSI_Rev.5.sch]
2020-11-03 TSI J13 & TSI J14
    [TSI_Rev.5.sch]
2020-11-03 NO J12
    [TSI_Rev.5.sch]
2020-11-03 J16 - Added added SL1_In
    [TSI_Rev.5.sch]
2020-11-03 Removed CAN Transciever from CAN & GLV Power, edited net listing on PCDC Circuit regarding Safety_Loop Iso and extraneous connector
    [Fault_Logic_And_Timing_Circuit.sch, Logic_Power_And_CAN_Isolators.sch, PCDC_Circuit.sch, Sensors-Throttle.sch, StatusLights_Cockpit.sch, TSI_Rev.5.sch, TSI_Throttle_Plausibility.sch]
2020-11-03 BP_HV - > Brake_Pressed_HV net list changes
    [CAN_GLV_POWER.sch, PCDC_Circuit.sch, TSI_Rev.5.sch]
2020-11-10 TSI Re-labeling
    [TSI_Rev.5.sch]
2020-11-10 Fixed Logic Board
    [Logic.sch, PiHat.sch]
2020-11-10 changed logic isolation
    [Logic.sch, LogicPower.sch, PiHat.sch]
2020-11-11 GLV with updated connector names, removed isolated converter and I2C isolator
    [GLV_BOBV6.sch]
2020-11-11 Added EPAL schematics and SLOOP
    [EPAL.kicad_pcb, EPAL.sch, SLOOP.kicad_pcb, SLOOP.sch]
2020-11-14 TSI with Cooling + Scada Relay, new Cooling Connector
    [CAN_GLV_POWER.sch, StatusLights_Cockpit.sch, TSI_Rev.5.sch]
2020-11-16 updated Epal and Sloop
    [SLOOP.sch]
2020-11-16 Added 24v to connection between GLV and Logic and updated headers accordingly
    [GLV_BOBV6.sch, Logic.sch, LogicPower.sch, PiHat.sch]
2020-11-16 Updated Pi GPIO and connector between Logic and TSI
    [CAN_GLV_POWER.sch, Logic.sch, PCDC_Circuit.sch, Sensors-Throttle.sch, StatusLights_Cockpit.sch, TSI_Rev.5.sch, TSI_Throttle_Plausibility.sch]
2020-11-16 updated Sloop once more
    [SLOOP.sch]
2020-11-17 Footprint Work
    [CAN_GLV_POWER.sch, Fault_Logic_And_Timing_Circuit.sch, PCDC_Circuit.sch, Sensors-Throttle.sch, StatusLights_Cockpit.sch, TSI_Rev.5.sch, TSI_Throttle_Plausibility.sch]
2020-11-17 Footprint Work II
2020-11-17 TSI: Added 24 to 12V converter, V dividers for IMD_Status, Throttle_PL, corrected pins 1-5 TSI-Logic Logic:24 to 5V non iso conv, safety_loop isolated, fixed I2C
    [CAN_GLV_POWER.sch, Logic.sch, LogicPower.sch, PiHat.sch, StatusLights_Cockpit.sch, TSI_Rev.5.sch, TSI_Throttle_Plausibility.sch]
2020-11-17 fixed some bullshit
    [CAN_GLV_POWER.sch, Fault_Logic_And_Timing_Circuit.sch, Logic.sch, PCDC_Circuit.sch, Sensors-Throttle.sch, StatusLights_Cockpit.sch, TSI_Rev.5.sch, TSI_Throttle_Plausibility.sch]
2020-11-17 - Fixed General Throttle Plausibility Nonsense - Added footprint and individual part for TS372
    [TSI_Throttle_Plausibility.sch]
2020-11-18 Sloop Latching Logique
    [SLOOP.sch]
2020-11-18 Added BOT brake light breaking
    [SLOOP.sch]
2020-11-18 Aesthetics, IMD Relay
    [CAN_GLV_POWER.sch, PCDC_Circuit.sch, Sensors-Throttle.sch, StatusLights_Cockpit.sch, TSI_Rev.5.sch, TSI_Throttle_Plausibility.sch]
2020-11-18 - removed Sloop Enable 1 & 2 from J6 - Wired J16 correctly
    [CAN_GLV_POWER.sch, TSI_Rev.5.sch, TSI_Throttle_Plausibility.sch]
2020-11-19 TSI Foot printing
    [PCDC_Circuit.sch, Sensors-Throttle.sch, TSI_Rev.5.sch, TSI_Throttle_Plausibility.sch]
2020-11-19 Carman Footprint Library, GLV PCB v1
    [GLV_BOBV6.sch]
2020-11-20 Fixed some broken connections/errors on TSI
    [CAN_GLV_POWER.sch, PCDC_Circuit.sch, Sensors-Throttle.sch, StatusLights_Cockpit.sch, TSI_Rev.5.sch]
2020-11-20 Logic Footprints in General Library, Added Logic LEDs
    [Logic.sch, LogicPower.sch, PiHat.sch]
2020-11-20 GLV PCB redone to be cleaner
    [GLV_BOBV6.kicad_pcb]
2020-11-22 GLV PCB edge cuts, logos, increased BATT+ trace widths, Gerber files
    [GLV_BOBV6-B_Cu.gbr, GLV_BOBV6-B_Mask.gbr, GLV_BOBV6-B_Paste.gbr, GLV_BOBV6-B_SilkS.gbr, GLV_BOBV6-Edge_Cuts.gbr, GLV_BOBV6-F_Cu.gbr, GLV_BOBV6-F_Mask.gbr, GLV_BOBV6-F_Paste.gbr]
2020-11-22 Added AIRS monitor signal to Pi, added all Logic Footprints
    [Logic.sch, PiHat.sch]
2020-11-23 Logic PCB started, Pi 3B footprint fixed
    [Logic.sch, LogicPower.sch, PiHat.sch]
2020-11-23 footprinting, datasheeting, general bug fixes * Added TSAL & TSAL Cockpit labels
    [CAN_GLV_POWER.sch, PCDC_Circuit.sch, Sensors-Throttle.sch, StatusLights_Cockpit.sch, TSI_Rev.5.sch]
2020-11-23 - TSAL_RTN connected to GLV_RTN
    [TSI_Rev.5.sch]
2020-11-24 Logic PCB updates, Fixed I2C and ground connections in Logic
    [GLV_BOBV6.kicad_pcb, Logic.kicad_pcb, Logic.sch]
2020-11-24 - TSI editing, Xsistor selection, footprints
    [CAN_GLV_POWER.sch, PCDC_Circuit.sch, StatusLights_Cockpit.sch, TSI_Rev.5.sch]
2020-11-25 Updated latching logic
    [SLOOP.sch, SLOOP_test.sch]
2020-11-26 updated Sloop once again
    [SLOOP.sch, SLOOP_test.sch]
2020-11-26 Safety Loops Edits to TSI
    [CAN_GLV_POWER.sch, Sensors-Throttle.sch, TSI_Rev.5.sch]
2020-11-27 - Aesthetics - TSI Safety Loop Edits - Battery pack connection editing
    [CAN_GLV_POWER.sch, StatusLights_Cockpit.sch, TSI_Rev.5.sch]
2020-11-27 - Aesthetics Part II
    [TSI_Rev.5.sch]
2020-11-27 Too big Logic PCB finished
    [Logic.kicad_pcb]
2021-01-11 GLV removed 24V to dash and 24V to BP headers. Logic almost done pending, design review
    [GLV_BOBV6-B_Cu.gbr, GLV_BOBV6-B_Mask.gbr, GLV_BOBV6-B_Paste.gbr, GLV_BOBV6-B_SilkS.gbr, GLV_BOBV6-Edge_Cuts.gbr, GLV_BOBV6-F_Cu.gbr, GLV_BOBV6-F_Mask.gbr, GLV_BOBV6-F_Paste.gbr]
2021-01-12 Smol Edits
    [CAN_GLV_POWER.sch, PCDC_Circuit.sch, Sensors-Throttle.sch]
2021-01-12 Added footprints for MCP6004
    [PCDC_Circuit.sch, Sensors-Throttle.sch, TSI_Rev.5.sch, TSI_Throttle_Plausibility.sch]
2021-01-12 Added Footprints for TS 912
    [TSI_Throttle_Plausibility.sch]
2021-01-12 TSI Footprints - Res, Caps, Inductor all 0805s - Mounting Holes
    [CAN_GLV_POWER.sch, PCDC_Circuit.sch, Sensors-Throttle.sch, StatusLights_Cockpit.sch, TSI_Rev.5.sch, TSI_Throttle_Plausibility.sch]
2021-01-12 TSI Footprints
2021-01-13 TSI Footprinting (~80%) - Added Molex - Added Current Sensor
    [CAN_GLV_POWER.sch, PCDC_Circuit.sch, Sensors-Throttle.sch, StatusLights_Cockpit.sch, TSI_Rev.5.sch, TSI_Throttle_Plausibility.sch]
2021-01-13 TSI Footprinting (~90%)
    [CAN_GLV_POWER.sch, PCDC_Circuit.sch, StatusLights_Cockpit.sch, TSI_Rev.5.sch, TSI_Throttle_Plausibility.sch]
2021-01-13 Bug Fixins
    [CAN_GLV_POWER.sch, PCDC_Circuit.sch, StatusLights_Cockpit.sch, TSI_Rev.5.sch]
2021-01-13 TSI Footprinting (~95%) - Added Silk Screen Images from last years projects (not added to any libraries, just folder)
    [CAN_GLV_POWER.sch, PCDC_Circuit.sch, StatusLights_Cockpit.sch, TSI_Throttle_Plausibility.sch]
2021-01-13 TSI Footprinting (~98%) - Assigned U41 footprint to PS1 footprint. Not able to find PS1 footprint. Referenced last years design and took measurement on PCB. Measured as the same distances between poi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
    [CAN_GLV_POWER.sch, PCDC_Circuit.sch, StatusLights_Cockpit.sch, TSI_Rev.5.sch, TSI_Throttle_Plausibility.sch]
2021-01-13 TSI Footprinting (~99%) - Need footprint for J1
    [CAN_GLV_POWER.sch]
2021-01-13 Small edits
    [TSI_Rev.5.sch]
2021-01-13 TSI Footprinting (100%) - Created symbol for connector J1
    [TSI_Rev.5.sch]
2021-01-14 Started TSI PCB
    [CAN_GLV_POWER.sch, PCDC_Circuit.sch, Sensors-Throttle.sch, TSI_Rev.5.kicad_pcb, TSI_Rev.5.sch]
2021-01-14 - Updated logic header footprints on TSI
    [TSI_Rev.5.kicad_pcb, TSI_Rev.5.sch]
2021-01-14 Started TSI layout
    [PCDC_Circuit.sch, TSI_Rev.5.kicad_pcb, TSI_Rev.5.sch]
2021-01-14 TSI High Voltage placed
    [TSI_Rev.5.kicad_pcb]
2021-01-14 Organized LV into groupings
    [CAN_GLV_POWER.sch, PCDC_Circuit.sch, TSI_Rev.5.kicad_pcb, TSI_Throttle_Plausibility.sch]
2021-01-14 Organizational Added jumper between chassis ground and can shield
    [TSI_Rev.5.kicad_pcb, TSI_Rev.5.sch]
2021-01-14 more TSI work
    [TSI_Rev.5.kicad_pcb]
2021-01-15 Low Voltage (Throttle Plausibility)
    [PCDC_Circuit.sch, TSI_Rev.5.kicad_pcb]
2021-01-15 HV Finished
    [TSI_Rev.5.kicad_pcb]
2021-01-15 LV Edited
    [TSI_Rev.5.kicad_pcb]
2021-01-16 TSI Layout (~65%)
    [TSI_Rev.5.kicad_pcb]
2021-01-16 TTSI Layout (~93%)
    [TSI_Rev.5.kicad_pcb]
2021-01-16 TSI (~95%) - Verify Safety Loop signal - Remove Testing connector/change signals - Place Test pads - Aesthetic tweaks
    [PCDC_Circuit.sch, TSI_Rev.5.kicad_pcb]
2021-01-16 TSI (~97%)
    [CAN_GLV_POWER.sch, PCDC_Circuit.sch, Sensors-Throttle.sch, TSI_Rev.5.kicad_pcb, TSI_Rev.5.sch, TSI_Throttle_Plausibility.sch]
2021-01-16 TSI (~98%) - Added right side testing connector - Finish left side testing connector - Added Caps to HV side
    [TSI_Rev.5.kicad_pcb, TSI_Rev.5.sch]
2021-01-17 TSI (~98.5%)
    [CAN_GLV_POWER.sch, PCDC_Circuit.sch, StatusLights_Cockpit.sch, TSI_Rev.5.kicad_pcb, TSI_Rev.5.sch, TSI_Throttle_Plausibility.sch]
2021-01-18 TSI (~99%) - Confirmed TSI pin headers and logic pin header alignment - Divided board into several sections - Placed TSV testing pads and made last connection
    [CAN_GLV_POWER.sch, Logic.kicad_pcb, TSI_Rev.5.kicad_pcb]
2021-01-18 Updated board, added silk art
    [Sensors-Throttle.sch, TSI_Rev.5.kicad_pcb, TSI_Rev.5.sch, TSI_Throttle_Plausibility.sch]
2021-01-18 Updated component links
    [TSI_Throttle_Plausibility.sch]
2021-01-18 Updated Components
    [PCDC_Circuit.sch]
2021-01-19 C13 Footprint
    [CAN_GLV_POWER.sch, TSI_Rev.5.sch]
2021-01-19 Changed RV4 and RV5 footprint
    [PCDC_Circuit.sch, TSI_Throttle_Plausibility.sch]
2021-01-19 TSI (99.5%) - Updated footprints on pcb
    [TSI_Rev.5.kicad_pcb]
2021-01-19 TSI Signal Review ISSUES: - PCDC 'Pre_Charge_Ready' and 'PC_Ready' discrepancy - TSI Rev.4 IC1, IC4 -> PCDC & Isolators
    REMOVED SIGNALS:
    Throttle Plausibility
    - PC_Ready
    - Drive_BTN
    PCDC
    - HV+
    - HV-
    - Throttle_HV
    - IGNI_GND
    STATUS LIGHTS & COCKPIT
    - BP
    - BP_RTN
    - IMD_Status
    - 5V
    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
    [PCDC_Circuit.sch, Sensors-Throttle.sch, StatusLights_Cockpit.sch, TSI_Rev.5.sch, TSI_Throttle_Plausibility.sch]
2021-01-20 Updated Signals and Trace Width
    [CAN_GLV_POWER.sch, Sensors-Throttle.sch, TSI_Rev.5.kicad_pcb, TSI_Rev.5.sch, TSI_Throttle_Plausibility.sch]
2021-01-20 Updated trace width and connector naming
    [TSI_Rev.5.kicad_pcb]
2021-01-20 TSI Updated
    [PCDC_Circuit.sch, TSI_Rev.5.kicad_pcb, TSI_Rev.5.sch]
2021-01-25 Logic Edge Cuts, TSI fixed safety loop and fault signals to dash-added inverters and V dividers, updated pcb and schematic
    [CAN_GLV_POWER.sch, Logic.kicad_pcb, TSI_Rev.5.kicad_pcb, TSI_Rev.5.sch]
2021-01-26 TSI removed inverter and made SL and Fault signals Active High using opto isolator for sch and pcb
    [CAN_GLV_POWER.sch, TSI_Rev.5.kicad_pcb]
2021-02-01 GLV Design Review Fixes
    [GLV_BOBV6.kicad_pcb]
2021-02-02 Logic Design Review Fixes
    [Logic.kicad_pcb]
2021-02-02 Added Cooling Power Jumper to TSI
    [CAN_GLV_POWER.sch, TSI_Rev.5.kicad_pcb]
2021-02-02 Redrew TSI iso lines
    [TSI_Rev.5.kicad_pcb]
2021-02-02 Changed TSI to ground pour
    [TSI_Rev.5.kicad_pcb]
2021-02-02 TSI PCB Aesthetic changes
    [TSI_Rev.5.kicad_pcb]
2021-02-03 Changed order of names on TSI Board
    [GLV_BOBV6.kicad_pcb, TSI_Rev.5.kicad_pcb]
2021-02-03 Contemplated homicide and fixed PC schematic
    [Logic.kicad_pcb, PCDC_Circuit.sch, TSI_Rev.5.kicad_pcb]
2021-02-05 Gerber and Drill Files for each board
    [GLV_BOBV6-B_Cu.gbr, GLV_BOBV6-B_Mask.gbr, GLV_BOBV6-B_SilkS.gbr, GLV_BOBV6-Edge_Cuts.gbr, GLV_BOBV6-F_Cu.gbr, GLV_BOBV6-F_Mask.gbr, GLV_BOBV6-F_SilkS.gbr, GLV_BOBV6-NPTH.drl]
2021-02-09 - Increased spacing between edge cuts and 24V - Labeled more in Low voltage
    [TSI_Rev.5.kicad_pcb]
2021-02-09 Small Changes
    [Logic.kicad_pcb]
2021-02-09 Logic Silkscreen Connector Descriptions added
    [Logic.kicad_pcb]
2021-02-09 TSI Silkscreen Connector Descriptions added
    [TSI_Rev.5.kicad_pcb]
2021-02-09 TSI silkscreen updated
    [TSI_Rev.5.kicad_pcb]
2021-02-09 GLV DR Fixes
    [GLV_BOBV6-B_Cu.gbr, GLV_BOBV6-B_Mask.gbr, GLV_BOBV6-B_SilkS.gbr, GLV_BOBV6-Edge_Cuts.gbr, GLV_BOBV6-F_Cu.gbr, GLV_BOBV6-F_Mask.gbr, GLV_BOBV6-F_SilkS.gbr, GLV_BOBV6-NPTH.drl]
2021-02-09 Fixed TSI cutouts and some silkscreen
    [TSI_Rev.5.kicad_pcb]
2021-02-09 GLV and Logic ready to be ordered
    [Logic-B_Cu.gbr, Logic-B_Mask.gbr, Logic-B_SilkS.gbr, Logic-Edge_Cuts.gbr, Logic-F_Cu.gbr, Logic-F_Mask.gbr, Logic-F_SilkS.gbr, Logic-NPTH.drl]
2021-02-10 TSI added LAf Logo and Made Gerber Files
    [TSI_Rev.5-B_Cu.gbr, TSI_Rev.5-B_Mask.gbr, TSI_Rev.5-B_SilkS.gbr, TSI_Rev.5-Edge_Cuts.gbr, TSI_Rev.5-F_Cu.gbr, TSI_Rev.5-F_Mask.gbr, TSI_Rev.5-F_SilkS.gbr, TSI_Rev.5-NPTH.drl]
2021-02-10 Zipped Gerber Files for all 3 boards
2021-02-16 Added 3D models for TSI board
    [39281023.stp, 39281043.stp, 39281063.stp, 39281083.stp, EHHD010A0B41-HZ--3DModel-STEP-56544.STEP, SFS2-DC24.step, TSI_Rev.5.kicad_pcb]
2021-02-16 Added 3D models for GLV board
    [39281023.stp, 39281043.stp, 39281063.stp, 39281083.stp, CUI_PYB20-Q24-S5-T.step, Logic.kicad_pcb]
2021-02-16 Added 3D models for GLV board (previous message was actually for Logic board)
    [39281023.stp, 39281043.stp, 39281063.stp, 39281083.stp, GLV_BOBV6.kicad_pcb]
2021-02-22 Fixed missing mounting holes on logic
    [Logic.kicad_pcb]
2021-02-22 Logic with Mounting Holes and Silkscreen Descriptions, new Gerber files
    [Logic-B_Cu.gbr, Logic-B_SilkS.gbr, Logic-Edge_Cuts.gbr, Logic-F_Cu.gbr, Logic-F_SilkS.gbr, Logic-NPTH.drl, Logic-PTH.drl, Logic-job.gbrjob]
2021-02-22 repushing credentials
    [Logic.kicad_pcb]
2021-02-22 - Updating TSI
    [CAN_GLV_POWER.sch, PCDC_Circuit.sch, Sensors-Throttle.sch, StatusLights_Cockpit.sch, TSI_Rev.5.sch]
2021-02-22 * Cool_Temp_In Error - Changed design to remove short from 3.3V to ground - New design reflects TSI Rev.4's CoolTemp design - Added CoolTemp_In signal and added it to J18 connector (Cooling Sensors)
    [StatusLights_Cockpit.sch, TSI_Rev.5.sch]
2021-02-22 Set IGNI_GND to IO_Ground, remove extraneous wire connection, Loaded new netlist
    [CAN_GLV_POWER.sch, Sensors-Throttle.sch, StatusLights_Cockpit.sch, TSI_Rev.5.kicad_pcb, TSI_Rev.5.sch]
2021-02-22 More Updates
    [StatusLights_Cockpit.sch, TSI_Rev.5.sch, TSI_Throttle_Plausibility.sch]
2021-02-22 fixed cooling on PCB
    [TSI_Rev.5.kicad_pcb]
2021-02-25 -> Updated battery pack connections, matched order with that on the pacman board
    [CAN_GLV_POWER.sch, TSI_Rev.5.sch]
2021-02-25 Changed signal notation for J11
    [CAN_GLV_POWER.sch, TSI_Rev.5.sch]
2021-02-26 Updated TSI notation
    [StatusLights_Cockpit.sch, TSI_Rev.5.sch]
2021-02-27 - Changed signals - J16.3 24V-> AIRS+ - Removed 'GEN_Fault_LED' (tied to MRESET Contact), I think it was the old General fault led signal
    [CAN_GLV_POWER.sch, TSI_Rev.5.sch]
2021-02-28 Test Push
    [TSI_Rev.5.sch]
2021-02-28 UPDATED AMS & IMD RELAY FOOTPRINT & SCHEMATIC
    [CAN_GLV_POWER.sch, TSI_Rev.5.kicad_pcb, TSI_Rev.5.sch]
2021-02-28 Updated IMD Signals
    [TSI_Rev.5.sch]
2021-02-28 Small PCB Changes
    [CAN_GLV_POWER.sch, TSI_Rev.5.kicad_pcb]
2021-02-28 - Removed Diodes across IMD Relay (K3), AMS Relay (K4), built in diodes in relay, additional diode messed with latching, latching confirmed w/o diode
    [CAN_GLV_POWER.sch, TSI_Rev.5.kicad_pcb]
2021-03-01 Edited Throttle Plausibility Braking circuit (was 24V, not AIRS+), renamed signals for clearer BRAKE_IN & BRAKE_OUT signals, BRAKE_OUT = Brake_Light
    [PCDC_Circuit.sch, TSI_Rev.5.kicad_pcb, TSI_Rev.5.sch, TSI_Throttle_Plausibility.sch]
2021-03-01 Notes on relay
    [TSI_Throttle_Plausibility.sch]
2021-03-01 -Updated RTDS, tested Xistor, can handle pulsed 90mA current
    [CAN_GLV_POWER.sch, StatusLights_Cockpit.sch]
2021-03-02 Try poosh again
    [StatusLights_Cockpit.sch]
2021-03-02 Renumbered headers & changed some footprints
    [CAN_GLV_POWER.sch, PCDC_Circuit.sch, Sensors-Throttle.sch, TSI_Rev.5.kicad_pcb, TSI_Rev.5.sch]
2021-03-02 Pin header updates
    [TSI_Rev.5.sch]
2021-03-02 Added LEDs for SCADA, AMS & IMD relays
    [CAN_GLV_POWER.sch]
2021-03-02 organizational update
    [CAN_GLV_POWER.sch, Sensors-Throttle.sch, TSI_Rev.5.sch, TSI_Throttle_Plausibility.sch]
2021-03-03 Other updates
    [TSI_Rev.5.sch]
2021-03-05 PCB Updates
    [TSI_Rev.5.kicad_pcb]
2021-03-05 Small updates
    [CAN_GLV_POWER.sch, TSI_Throttle_Plausibility.sch]
2021-03-08 Updated C13 footprint such that it is through hole not SMD
    [CAN_GLV_POWER.sch]
2021-03-08 Updated Brake_Pressed_uC Signal
    [CAN_GLV_POWER.sch, TSI_Rev.5.kicad_pcb, TSI_Rev.5.sch, TSI_Throttle_Plausibility.sch]
2021-03-09 TSI Updated & error fixes: added pull down resistors, and 5V_ISO_RTN
    [CAN_GLV_POWER.sch, StatusLights_Cockpit.sch, TSI_Rev.5.kicad_pcb, TSI_Rev.5.sch, TSI_Throttle_Plausibility.sch]
2021-03-09 Updated D2 Footprint
    [TSI_Rev.5.kicad_pcb, TSI_Throttle_Plausibility.sch]
2021-03-12 ADDED K1-APAN3105 Relay to symbol and footprint libraries
    [CAN_GLV_POWER.sch, PCDC_Circuit.sch, TSI_Rev.5.kicad_pcb]
2021-03-12 Updated C14 with mouser part number
    [StatusLights_Cockpit.sch]
2021-03-12 Updated parts U19 & U12 to have their actual names so we can order them in the future
    [PCDC_Circuit.sch, TSI_Rev.5.kicad_pcb]
2021-03-12 Updated D6 & D7 fields, assigned them specific LED that is also used by logic and GLV (VAOL-S8GT4)
    [PCDC_Circuit.sch]
2021-03-15 Throttle Plausibility comments
    [PCDC_Circuit.sch, TSI_Throttle_Plausibility.sch]
2021-03-15 Added comments
    [PCDC_Circuit.sch, TSI_Rev.5.sch]
2021-03-15 Added Comments, added TP for throttle plausiblity
    [TSI_Rev.5.sch, TSI_Throttle_Plausibility.sch]
2021-03-16 Changed R1 from 76K to 1K, fixing the voltage reference (D2) issue for Throttle Plausibility
    [TSI_Throttle_Plausibility.sch]
2021-03-17 - removed testing headers (All pins were easily testable, one that weren't received testing points) - Added pull up resistor at drain of SCADA Relay - Fixed issue with U27-PC_Ready signal not being i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
    [CAN_GLV_POWER.sch, PCDC_Circuit.sch, StatusLights_Cockpit.sch, TSI_Rev.5.kicad_pcb, TSI_Rev.5.sch, TSI_Throttle_Plausibility.sch]
2021-03-17 - Removed pull up resistor - Changed the relay leds such that they are the ones logic and GLV Bob use
    [CAN_GLV_POWER.sch, TSI_Rev.5.kicad_pcb, TSI_Rev.5.sch]
2021-03-17 Removed D11 (RTDS Zener diode), made RTDS sound warbled and trash
    [StatusLights_Cockpit.sch, TSI_Rev.5.kicad_pcb]
2021-03-17 Added datasheets
    [PCDC_Circuit.sch]
2021-03-26 Added additional TLP for 24V safety loop for epal moved D14 moved to output of U35
    [CAN_GLV_POWER.sch, PCDC_Circuit.sch]
2021-03-26 Changed C60 from 1uF to 0.01uf
    [CAN_GLV_POWER.sch]
2021-03-29 - Added pull up resistor to U21B differential circuit - Removed zener across PC relay
    [PCDC_Circuit.sch, Sensors-Throttle.sch]
2021-03-29 Notes on DC Relay Current Draw
    [TSI_Rev.5.sch]
2021-03-29 DC PC Relay Comments
    [PCDC_Circuit.sch]
2021-03-31 - Removing IC1/ Diffamp_Ref (1.24V)
    [PCDC_Circuit.sch, Sensors-Throttle.sch, TSI_Rev.5.sch]
2021-03-31 - Added a Throttle Plausible Green LED
    [PCDC_Circuit.sch, Sensors-Throttle.sch, TSI_Throttle_Plausibility.sch]
2021-03-31 Fixed Throttle Voltage Iso, U21B had the wrong inputs to the +/- terminals
    [PCDC_Circuit.sch, Sensors-Throttle.sch]
2021-03-31 Small Changes & Updated PCB
    [Sensors-Throttle.sch, TSI_Rev.5.kicad_pcb, TSI_Rev.5.sch]
2021-03-31 Added Pre-Charge Control Test Point
    [PCDC_Circuit.sch]
2021-04-01 Updated RTDS sound & added comments
    [CAN_GLV_POWER.sch, PCDC_Circuit.sch, StatusLights_Cockpit.sch]
2021-04-01 - SR Control boosted and scada relay circuit edited
    [CAN_GLV_POWER.sch]
2021-04-02 Datasheets and notes
    [CAN_GLV_POWER.sch, PCDC_Circuit.sch, StatusLights_Cockpit.sch, TSI_Rev.5.sch, TSI_Throttle_Plausibility.sch]
2021-04-02 General numbering
    [CAN_GLV_POWER.sch, PCDC_Circuit.sch, Sensors-Throttle.sch, TSI_Throttle_Plausibility.sch]
2021-04-02 Comments for PC/DC
    [CAN_GLV_POWER.sch, PCDC_Circuit.sch]
2021-04-02 Added jumpers across HV-, HV+ & MC+ voltage dividers Comments added to PC Circuit
    [PCDC_Circuit.sch, Sensors-Throttle.sch, TSI_Rev.5.kicad_pcb, TSI_Throttle_Plausibility.sch]
2021-04-02 Updated Resistor values for LEDs
    [PCDC_Circuit.sch, Sensors-Throttle.sch, StatusLights_Cockpit.sch, TSI_Rev.5.sch, TSI_Throttle_Plausibility.sch]
2021-04-05 Jumpers across AMS & IMD Reset button for testing capabilities Jumper across IMD for easier testing capability Remove Brake_Pressed_HV signal from TSI board, originally designed for regenerative brak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
    [CAN_GLV_POWER.sch, PCDC_Circuit.sch, TSI_Rev.5.kicad_pcb, TSI_Rev.5.sch]
2021-04-05 small push
    [TSI_Throttle_Plausibility.sch]
2021-04-05 Added back 1.24HV_Ref signal. One reference signal purely supplies 1.24HV pull up for Sensors_Throttle_Voltage sheet. The other reference, which is adjustable by potentiometer RV3, drives the TSV_MIN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
    [PCDC_Circuit.sch, Sensors-Throttle.sch, TSI_Rev.5.kicad_pcb, TSI_Rev.5.sch]
2021-04-05 Updated notes for MC
    [TSI_Rev.5.sch, TSI_Throttle_Plausibility.sch]
2021-04-05 Updated U19 footprint, changed to TSSOP-14, cross-referenced footprint with mouser product info footprint
    [CAN_GLV_POWER.sch, PCDC_Circuit.sch, StatusLights_Cockpit.sch, TSI_Throttle_Plausibility.sch]
2021-04-05 redesigned Safety loop logic
    [CAN_GLV_POWER.sch, PCDC_Circuit.sch]
2021-04-06 - Removed capacitors across R16, R53, R6 - Capacitive load was too much for 1.24HV Ref - Notes on Pre-charge circuit & Throttle Plausibility - Cooling, Relays & Voltage Refs
    [CAN_GLV_POWER.sch, PCDC_Circuit.sch, Sensors-Throttle.sch, StatusLights_Cockpit.sch, TSI_Rev.5.kicad_pcb, TSI_Throttle_Plausibility.sch]
2021-04-06 General signal directions -> i/o
    [CAN_GLV_POWER.sch, PCDC_Circuit.sch, Sensors-Throttle.sch, StatusLights_Cockpit.sch, TSI_Rev.5.sch, TSI_Throttle_Plausibility.sch]
2021-04-07 Added Safety Loop testing jumpers to top level page. If we don't want it we can axe it by just deleting off top level
    [CAN_GLV_POWER.sch, Sensors-Throttle.sch, StatusLights_Cockpit.sch, TSI_Rev.5.kicad_pcb, TSI_Rev.5.sch]
2021-04-07 - Added Test point TSV_MIN_REF - Removed DC_RELAY- signal. changed DC_RELAY- to be IO_Ground instead of IO_Ground shorted to DC_RELAY-, question of net-listing names on board layout more than anythin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
    [PCDC_Circuit.sch, TSI_Rev.5.sch]
2021-04-07 Changed D6, Pre-Charge LED to a better circuit, wasn't working before. floating voltage at gate of Xsistor U9 was turning it on always
    [PCDC_Circuit.sch]
2021-04-07 changed the "speical" footprint of U9 to the correct one
    [PCDC_Circuit.sch]
2021-04-07 speical fallout
    [TSI_Rev.5.kicad_pcb]
2021-04-07 Pre-Charge Works
    [PCDC_Circuit.sch, TSI_Rev.5.sch]
2021-04-07 Updated TSI
    [TSI_Rev.5.kicad_pcb, TSI_Rev.5.sch]
2021-04-08 Updated board
    [PCDC_Circuit.sch, TSI_Rev.5.sch]
2021-04-08 Logic schematic organized
    [Logic.sch]
2021-04-08 Updated Logic again
    [Logic.sch]
2021-04-08 - limited shorting wires and clarified ISO connections - Removed 5V_rtn and 3.3V_rtn and changed to ISO_RTN - 3.3V designated as 3.3V_ISO - 5V designated as 5V_ISO
    [Logic.sch, LogicPower.sch, PiHat.sch]
2021-04-08 Logic Further organization
    [Logic.sch, PiHat.sch]
2021-04-08 Super organized logic
    [Logic.sch, LogicPower.sch, PiHat.sch]
2021-04-09 Logic Update
    [Logic.sch, LogicPower.sch, PiHat.sch]
2021-04-09 - Removed 5V_NON_ISO -> 3.3V_NON_ISO voltage divider, apparently voltage div put res in // with bi directional transceiver
    [Logic.sch, LogicPower.sch]
2021-04-09 - Adding J10 -> non isolated i2C testing header
    [Logic.sch, PiHat.sch]
2021-04-09 Logic updated
    [Logic.kicad_pcb, Logic.sch, PiHat.sch]
2021-04-09 Updated TSI-Logic connection
    [Logic.sch, PCDC_Circuit.sch, TSI_Rev.5.sch, TSI_Throttle_Plausibility.sch]
2021-04-09 MEGA UPDATE - Changed PC_Ready isolation from logic ISO rtn to GLV_RTN (U27) because it is sent over GPIO - Changed GPIO pins - Added 24V -> 5V TLP stepdown for AMS_FAULT_LED & IMD_FAULT_LED (U29,U31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
    [CAN_GLV_POWER.sch, Logic.kicad_pcb, Logic.sch, PCDC_Circuit.sch, Sensors-Throttle.sch, StatusLights_Cockpit.sch, TSI_Rev.5.kicad_pcb, TSI_Rev.5.sch]
2021-04-09 - Added SDA & SCL pull-up resistors (to 5V) - Confirmed that all inputs to the GPIO is 5V - Eliminated redundancy of SDA & SCL signals, one signal pervades through whole TSI board and is shorted to S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
    [CAN_GLV_POWER.sch, Logic.sch, Sensors-Throttle.sch, StatusLights_Cockpit.sch, TSI_Rev.5.kicad_pcb, TSI_Rev.5.sch, TSI_Throttle_Plausibility.sch]
2021-04-12 Added isolation and state LEDS
    [Logic.sch, StatusLights_Cockpit.sch, TSI_Rev.5.sch]
2021-04-12 Redid PCB added new cooling converter footprint and symbol
    [CAN_GLV_POWER.sch, Logic.sch, PCDC_Circuit.sch, Sensors-Throttle.sch, TSI_Rev.5.kicad_pcb, TSI_Rev.5.sch]
2021-04-13 routed TSI board
    [Logic.kicad_pcb, Logic.sch]
2021-04-14 Small aesthetic changes
    [CAN_GLV_POWER.sch, PCDC_Circuit.sch, StatusLights_Cockpit.sch, TSI_Rev.5.sch, TSI_Throttle_Plausibility.sch]
2021-04-14 TSI Rev. 5.1 PCB Updates
2021-04-15 More TSI routing optimization
    [TSI_Rev.5.sch]
2021-04-15 Aggregated Logic to one connector
2021-04-16 Balls balls balls
    [Logic.kicad_pcb, Logic.sch]
2021-04-16 logic & TSI lay out
    [Logic.kicad_pcb]
2021-04-19 TSI Logic Changes
    [Logic.kicad_pcb, Logic.sch]
2021-04-20 TSI Logic changes the 2nd
    [Logic.kicad_pcb, Logic.sch, TSI_Rev.5.sch]
2021-04-23 Updated TSI Schematic
    [Logic.sch, PCDC_Circuit.sch, PiHat.sch, StatusLights_Cockpit.sch, TSI_Rev.5.sch]
2021-04-23 Added Footprint for Pi RTC. organized board
    [Logic.sch, PiHat.sch]
2021-04-23 -Added buttons across coils (instead of jumpers) for the AMS & IMD relays - Added push button for RTDS testing - Added a header (Currently J22) such that we can hook up a SPDT switch and change direc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
    [Logic.sch, PiHat.sch, StatusLights_Cockpit.sch, TSI_Rev.5.sch]
2021-04-24 Updated board & schematics
    [TSI_Rev.5.sch, TSI_Throttle_Plausibility.sch]
2021-04-25 Reorganization of symbol library
    [PCDC_Circuit.sch, TSI_Throttle_Plausibility.sch]
2021-04-26 Added one more safety loop jumper for easier testing of pre-charge/discharge circuit
    [TSI_Rev.5.kicad_pcb, TSI_Rev.5.sch]
2021-04-26 Logic, TSI & GLV revisions
    [GLV_BOBV6.kicad_pcb, GLV_BOBV6.sch, Logic.kicad_pcb, Logic.sch, PCDC_Circuit.sch, TSI_Rev.5.sch]
2021-04-26 Finish cap connections - res values for CoolTemp_in ->TSI
    [Logic.kicad_pcb, Logic.sch]
2021-04-27 Fixed GLV header names
    [GLV_BOBV6.kicad_pcb, Logic.kicad_pcb]
2021-04-27 Logic Board layout done
    [Logic.kicad_pcb, Logic.sch]
2021-04-27 Small update
    [GLV_BOBV6.sch, Logic.kicad_pcb]
2021-04-27 Logic board aesthetics
    [Logic.kicad_pcb, Logic.sch]
2021-04-27 Gerber Files
    [GLV_BOBV6-B_Cu.gbr, GLV_BOBV6-B_Mask.gbr, GLV_BOBV6-B_SilkS.gbr, GLV_BOBV6-Edge_Cuts.gbr, GLV_BOBV6-F_Cu.gbr, GLV_BOBV6-F_Mask.gbr, GLV_BOBV6-F_SilkS.gbr, GLV_BOBV6-NPTH.drl]
2021-04-27 updated GLV bypass cap current sensor
    [GLV_BOBV6-B_Cu.gbr, GLV_BOBV6-B_Mask.gbr, GLV_BOBV6-B_SilkS.gbr, GLV_BOBV6-Edge_Cuts.gbr, GLV_BOBV6-F_Cu.gbr, GLV_BOBV6-F_Mask.gbr, GLV_BOBV6-F_SilkS.gbr, GLV_BOBV6-NPTH.drl]
2021-04-28 KiCAD Library Reorganization - Easier for next year
    [TSI_Rev.5-B_Cu.gbr, TSI_Rev.5-B_Mask.gbr, TSI_Rev.5-B_SilkS.gbr, TSI_Rev.5-Edge_Cuts.gbr, TSI_Rev.5-F_Cu.gbr, TSI_Rev.5-F_Mask.gbr, TSI_Rev.5-F_SilkS.gbr, TSI_Rev.5-NPTH.drl]
2021-04-28 Organized GLV Files
    [GLV_BOBV6-B_Cu.gbr, GLV_BOBV6-B_Mask.gbr, GLV_BOBV6-B_Paste.gbr, GLV_BOBV6-B_SilkS.gbr, GLV_BOBV6-Edge_Cuts.gbr, GLV_BOBV6-F_Cu.gbr, GLV_BOBV6-F_Mask.gbr, GLV_BOBV6-F_Paste.gbr]
2021-05-12 TSi - Fixed Symbol issue for U5, I2C Isolator
    [Sensors-Throttle.sch]
2021-05-14 LOGIC: Added pull-up resistors on non-isolated side of I2C TSI: Added silkscreen labeling and comments GLV: Organized GLV schematic, increased mounting hole size to 3.5mm from 2.5mm
    [GLV_BOBV6.sch, Logic.kicad_pcb, Logic.sch, StatusLights_Cockpit.sch, TSI_Rev.5.kicad_pcb, TSI_Rev.5.sch]
2022-02-08 Updated the wiring on the schematic according to the errata update from Marwa
    [Logic.sch, LogicPower.sch]
2022-02-15 Updated the logic board schematic and layout
    [Logic.kicad_pcb, Logic2.kicad_pcb]
2022-03-07 Created a new logic board directory for the new logic schematic update
    [39281023.stp, 39281043.stp, 39281063.stp, 39281083.stp, CUI_PYB20-Q24-S5-T.step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]
2022-03-07 Created the Pi Shield schematic and a new library for pican2
    [PiShield.sch]
2022-03-07 Create the regulator circuit based on the P783-S datasheet
    [PiShield.sch]
2022-03-08 Added the Pi shield components as well as the footprints needed
    [PiShield.sch]
2022-03-08 Created the PCB layout of the Pi shield
    [PiShield.kicad_pcb, PiShield.sch]
2022-03-09 Update the PCB layout with the wiring connected
    [Logic.sch, PiShield.kicad_pcb, PiShield.sch]
2022-03-09 Fixed the PCB layout wiring error detected by the rule checker
    [PiShield.kicad_pcb]
2022-03-09 TSI Rev.7 Sch
    [39281023.stp, 39281043.stp, 39281063.stp, 39281083.stp, CAN_GLV_POWER.sch, EHHD010A0B41-HZ--3DModel-STEP-56544.STEP, Fault_Logic_And_Timing_Circuit.sch, Logic_Power_And_CAN_Isolators.sch]
2022-03-10 TSI Should be final schematic
    [CAN_GLV_POWER.sch, PCDC_Circuit.sch, PIC32.sch, Sensors-Throttle.sch, StatusLights_Cockpit.sch, TSI_Rev.7.sch, TSI_Throttle_Plausibility.sch]
2022-03-10 removed u41 power
    [PCDC_Circuit.sch]
2022-03-10 Updated the footprints
    [PiShield.kicad_pcb, PiShield.sch]
2022-03-11 TSI Post-Nadovich
    [CAN_GLV_POWER.sch, PCDC_Circuit.sch, PIC32.sch, Sensors-Throttle.sch, StatusLights_Cockpit.sch, TSI_Rev.7.sch, TSI_Throttle_Plausibility.sch]
2022-03-11 BOM, Errata, TODO
    [TSI_Rev.7_BOM.csv]
2022-03-11 TSI REV7 Final Schematic before Layout
    [PCDC_Circuit.sch, PIC32.sch, StatusLights_Cockpit.sch, TSI_Rev.7.sch, TSI_Throttle_Plausibility.sch]
2022-03-11 Fixed annotation issue
    [PCDC_Circuit.sch]
2022-03-11 Fixed missing footprint on J28
    [TSI_Throttle_Plausibility.sch]
2022-03-11 Updated Schematic and removed extra footprints from PCB. Ready to begin routing new elements in.
    [CAN_GLV_POWER.sch, PCDC_Circuit.sch, StatusLights_Cockpit.sch, TSI_Rev.7.kicad_pcb, TSI_Rev.7.sch, TSI_Rev.7_BOM.csv, TSI_Throttle_Plausibility.sch]
2022-03-11 Finished PCB for REV7
    [PIC32.sch, TSI_Rev.7.kicad_pcb]
2022-03-15 Rev 7 gerber files and BOM added
    [TSI_Rev.7-B_Cu.gbr, TSI_Rev.7-B_Mask.gbr, TSI_Rev.7-B_SilkS.gbr, TSI_Rev.7-Edge_Cuts.gbr, TSI_Rev.7-F_Cu.gbr, TSI_Rev.7-F_Mask.gbr, TSI_Rev.7-F_SilkS.gbr, TSI_Rev.7-job.gbrjob]
